zx90316/split-flap/mega2560/hall-diagnostics.md

# KY-003：確認輸出，再決定磁鐵方案

[分享對話](https://claude.ai/share/2f5c9351-a46a-44d2-a825-716c9a015ebe)回報：十片行為類似，元件標示`3144`／`306Y`；黑色磁鐵測試有時維持亮燈，正面觸發、反面解除；供電5V、S未接控制器、無磁場時量到 **3.39V**；2×1mm磁鐵當時未到貨。這是對話紀錄，尚無本repo實測波形或電路圖。

## 3.39V 不足以判定電路或鎖存

不能只憑這個數字斷定供電接錯、沒有上拉、一定透過LED上拉、是假3144或一定鎖存。S是訊號輸出，不必然等於供電；模組LED／電阻電路可能不同，電表讀值受上拉、漏電與負載影響。不能以「5V−LED 1.6V」直接認定內部電路。

[Allegro A3144原廠資料表](https://www.allegromicro.com/~/media/Files/Datasheets/A3141-2-3-4-Datasheet.ashx?la=en)描述單極開集極開關：磁場超動作門檻拉低，低於釋放門檻後釋放，需適當上拉。它不能證明相容品型號或模組走線，`306Y`也不足以辨識功能。

程式使用 **INPUT_PULLUP**，列出raw及觸發狀態，不對電壓作軟體認證。接上後須重新量S高低電位，並確認馬達開關時穩定。輸入門檻與供電有關，不能只因3.39V讀得到就忽略雜訊餘量；參考 [ATmega2560原廠資料](https://www.microchip.com/en-us/product/ATmega2560)與實板供電。

## 不轉馬達的確認流程

1. **關閉12V馬達分支**。查實板S／正電源／地，不能假設所有模組中間腳是+；裸IC腳序也不等於模組排針。
2. 先量+對−約5V，再記錄S對−在未觸發、靠近、直線移遠、換極時的電位與LED。沒有模組電路證據，LED只作輔助。
3. 接S→A0、+→Mega 5V、−→GND，`WATCH`：預設raw=LOW U0=1是觸發，raw=HIGH U0=0是釋放。`x`加換行退出。
4. 用磁極較明確的硬磁鐵，同一面靠近，再**不翻面、沿直線移離到充分遠**；約30cm可作桌面排查起點，同時移開磁化鐵件。不要以多極冰箱軟磁片作定論。
5. 若會回HIGH，再用實際2×1mm磁鐵、安裝距離驗證每圈單一磁區。若供電針序正常、移遠仍LOW、另一極可重複解除，先記為**疑似鎖存行為**，進一步對照料號資料／量測，不憑印字判真偽。
6. S接上INPUT_PULLUP後負載會改變，必須重測。持續LOW還需排除短路、錯腳、供電不穩、元件故障，不能宣稱只有鎖存一種原因。

| 模組 | +/−電壓 | S未接控制器 | S接INPUT_PULLUP | 靠近LOW | 移遠回HIGH | 翻極反應 | 備註 |
| --- | --- | --- | --- | --- | --- | --- | --- |
| U0 |  | 對話回報3.39V；待重測 |  |  |  |  |  |
| U1–U9 | 各片記錄 |  |  |  |  |  |  |

## 確認鎖存後的選項

基準機構每顆一磁鐵，離開後感測器應釋放。鎖存若只遇觸發極，不會自行回復，HOME會在離開磁區報`hall_did_not_release`，MEASURE也無法取得每圈新邊緣。改POLARITY或加長逾時無法修正。

可換已驗證非鎖存感測器；或**確認鎖存後**評估每顆兩個相反有效磁極，每圈在固定位置解除、觸發。十顆增為二十顆是這個選項的用量，不是本次已確定購買需求。

雙磁鐵須在實際滾筒驗證：同感測軌跡、磁場不互擾、每圈只有一個可重複的未觸發→觸發邊緣；兩段電位都足以穩定5ms，任意停點都能在步數／時間限制內先解除再觸發。**沒有「相隔90°一定成功」的通用保證**，本repo未新增孔位，也未做雙磁鐵實機驗證。

HOME／MEASURE使用相同邊緣流程，可測這種行為，但不代表機構已相容。方案變更後重測OFFSET與圈步數，不直接沿用單磁鐵校準。
