zx90316/split-flap/esp32cam/ui-preview.jpg

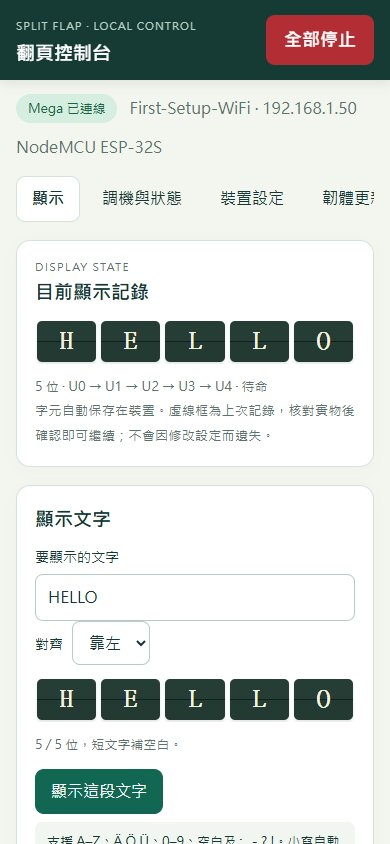
esp32cam/ui-preview.jpg
