zx90316/split-flap/hardware/project-bom.csv

item_id | item_name | specification | required_quantity | unit | quantity_basis | design_role | verification_needed | bench_quantity | recommended_purchase_quantity | availability
P001 | ULN2003 驅動板 | ULN2003；四相五線；輸入與插座映射須確認 | 10 | 片 | 十字元電氣設計 | 每字元一片低側驅動；COM 接 12V_MOTOR | 實際 IC、IN1–IN7 與馬達插座映射、輸入負載、reset 時關閉狀態、COM、額定值 | 1 |  | 依對話已有；未盤點
P002 | 28BYJ-48 步進馬達 | 28BYJ-48-12VDC；12V；四相五線 | 10 | 顆 | 十字元電氣設計 | U0–U9 各一顆 | 電壓標示、共同端、線圈電阻、相序、齒比、每圈步數、歸零偏移 | 1 |  | 依對話已有；未盤點
P004 | 雙面洞洞板 | 5×7 cm | 2 | 片 | 初始載板佈局；須試排 | Hall 3P 分線板與接線固定；孔位配置見 mega2560/README.md | 孔距、焊盤連通、實際佈局、絕緣與固定 | 1 |  | 依對話已有；未盤點
P005 | KY-003 霍爾感測板 | KY-003；數位磁感測 | 10 | 片 | 十字元電氣設計 | Mega A0–A9；5V供電；INPUT_PULLUP | 回報標示3144/306Y；針序、磁極、釋放行為及上拉待驗；3.39V不足以判定鎖存或內部電路 | 1 |  | 依對話已有；未盤點
P006 | 免焊 DC 母接頭 | 母頭 5.5×2.1 mm | 1 | 個 | 十字元電氣設計 | 標準 12V 輸入接頭；與電源插頭規格配對 | 極性、接點電流額定值、與供電插頭適配及固定 | 1 |  | 待確認
P011 | 8 路雙向電平轉換板 | 現有8路；3.3V／5V；分立MOS布局 | 1 | 片 | NodeMCU ESP-32S與Mega Pro UART | GPIO13→A0／B0→D19；D18→B1／A1→GPIO14；VCCA=3V3；VCCB=Mega5V | 各側電壓與共地；115200短線實測；不假設單側斷電隔離；切換供電前拔四條訊號線 | 1 | 0 | 依使用者已有；照片8路板；由選配移入
P012 | M3 熱熔螺母 | M3×0.5；Ø4.6×L5.8 mm | 14 | 顆 | 上游機構參考；須試裝確認 | 原中框與前蓋參考需求 14 顆 | 孔徑、埋入長度、壁厚與材料適配 |  |  | 待確認
P013 | M2×4 十字盤頭螺絲 | M2×0.4；長 4 mm | 20 | 支 | 上游機構參考；須試裝確認 | 原 Hall 固定參考需求 20 支；新 Hall 孔位待驗 | 頭型、長度、Hall 孔位與螺紋 |  |  | 待確認
P014 | M2×8 十字盤頭螺絲 | M2×0.4；長 8 mm | 20 | 支 | 上游機構參考；須試裝確認 | 原滾筒參考需求 20 支 | 頭型、長度、插入深度與滾筒干涉 |  |  | 待確認
P015 | M3×8 十字盤頭螺絲 | M3×0.5；長 8 mm | 12 | 支 | 上游機構參考；須試裝確認 | 原前蓋與後蓋參考需求 12 支 | 頭型、長度與固定配合 |  |  | 待確認
P016 | M4×8 十字盤頭螺絲 | M4×0.7；長 8 mm | 20 | 支 | 上游機構參考；須試裝確認 | 原馬達固定參考需求 20 支 | 頭型、長度與馬達耳孔 |  |  | 待確認
P017 | M4×20 十字盤頭螺絲 | M4×0.7；長 20 mm | 4 | 支 | 上游機構參考；須試裝確認 | 原中框參考需求 4 支 | 頭型、長度與固定配合 |  |  | 待確認
P018 | M3 六角螺帽 | M3×0.5；DIN934 | 32 | 顆 | 上游機構參考；須試裝確認 | 原 UnitFrame／前後蓋參考需求 32 顆 | 尺寸與螺帽嵌入孔 |  |  | 待確認
P019 | M4 六角螺帽 | M4×0.7；DIN934 | 4 | 顆 | 上游機構參考；須試裝確認 | 原中框參考需求 4 顆 | 尺寸與螺帽嵌入孔 |  |  | 待確認
P020 | M2 熱熔螺母 | M2×0.4；Ø3.59×L3.94 mm | 20 | 顆 | 上游機構參考；須試裝確認 | 原滾筒參考需求 20 顆 | 孔徑、埋入長度、壁厚與材料適配 |  |  | 待確認
P021 | M3×16 內六角杯頭螺絲 | M3×0.5；長 16 mm；DIN912 | 34 | 支 | 上游機構參考；須試裝確認 | 原 UnitFrame／前後蓋參考需求 34 支 | 頭型、長度與固定配合 |  |  | 待確認
P022 | 圓片釹磁鐵 | 2×1 mm | 10 | 顆 | 上游機構參考；須試裝確認 | 每字元歸零磁鐵 | 非鎖存單磁鐵基準10顆；確認鎖存並驗證雙磁鐵後才改為20顆 | 1 |  | 待確認
P023 | 穩壓直流電源 | 隔離式 12V DC | 1 | 組 | 十字元電氣設計 | 供馬達及LM2596控制支路；馬達分支可獨立切斷 | 依最大負載選連續/峰值額定電流；極性與接頭 | 1 |  | 待確認
P024 | 插片式保險絲座與配套保險絲 | 已購中號18AWG選項標5A×2；實際保險絲額定另核定 | 2 | 組 | 12V主輸入F1及5V控制支路F2 | F1靠近12V輸入口；F2在LM2596的5V輸出後 | 是否附保險絲；DC額定、最弱線材／接點、並行總電流、線長與熔斷曲線；不預設兩路5A | 2 | 0 | 2026-10-26使用者購買清單；已下單待出貨；未實機驗收
P025 | 直流電源開關 | 符合實測直流負載 | 2 | 個 | 十字元電氣設計 | 主電源開關及獨立馬達分支切斷 | 感性負載切斷能力、突波與可及性 | 2 |  | 待確認
P026 | 電源線、端子與分配件 | 主幹18–20AWG為起點；短單馬達分支可評估24AWG；依長度和額定值驗證 |  | 組 | 依佈線決定 | 12V/5V/地線分配 | 不可用未知線規杜邦線承擔馬達主幹 |  |  | 待確認
P027 | 訊號配線與接頭 | 短線 I²C、Hall 與相位接線 |  | 組 | 依佈線決定 | 其餘短線和標籤；多P線分列C001–C005；Pro公針用母頭、標準Mega母排用公頭 | 導通、標籤、拉力與雜訊 |  |  | 待確認
P028 | 固定柱、絕緣與應力消除件 | 依板孔及外殼選型 |  | 組 | 依實際固定方式決定 | 安全固定模組與配線 | 爬電間距、無裸線短路、機構干涉 |  |  | 待確認
P029 | 上拉、下拉與去耦元件 | 依模組內建電路和量測選型 |  | 組 | 依實測電路決定 | ULN相位下拉（10kΩ起點）及Hall上拉、去耦依實測配置 | 0–40相下拉；驗證reset與USB拔除狀態；無MCP RESET線 |  |  | 待確認
P031 | 翻頁片 | 與上游 45 字元順序一致 | 450 | 片 | 上游機構參考；須試裝確認 | 每字元 45 片 | 字元版本、厚度、翻落與排列 |  |  | 待確認
P032 | 滾筒與單元框架 | FlapDrumInner / Outer / FrameUnit | 10 | 組 | 上游機構參考；須試裝確認 | 十個字元單元 | 尺寸、摩擦、模組安裝孔 | 1 |  | 待確認
P033 | 中框、前蓋與後蓋 | 每類各左中右三件 | 1 | 套 | 上游機構參考；須試裝確認 | 整機外殼 | 插座與載板固定、絕緣及散熱 |  |  | 待確認
P034 | Arduino Mega 2560 | ATmega2560；5V；16MHz | 0 | 片 | Mega十字元規劃；現階段單顆測試 | 歷史硬體；非本次新主控 | 板型、母排、USB、reset時輸出關閉 | 0 | 0 | 原標準Mega仍保留；現行改用P040；舊板可備份校準
P035 | Mega USB 資料線 | Mega Pro板上USB接頭到貨核對；必須支援資料 | 1 | 條 | Mega燒錄與單板USB調機 | USB供電與115200串列 | USB與外部5V互斥；先拔板間四條UART訊號線；新COM不可沿用舊板號 | 1 | 1 | 待確認
C001 | 4P 馬達相位線 | Pro公針與ULN公針用母母；依各邏輯腳拆分束線 | 10 | 條 | Mega十字元規劃；現階段單顆測試 | 每字元一條；U9 D8–D11 | Pro排位不同；D22/24/26/28等不保證連續四針；不能按標準板外觀搬接 | 1 | 12 | 待確認
C002 | 3P Hall 線 | 2.54mm母對母；兩端元件為公針時 | 10 | 條 | Mega十字元規劃；現階段單顆測試 | 每字元一條；S/+/-由分線板分配 | 腳序依實物；不可把圖上順序當通用針序 | 1 | 12 | 待確認
C003 | 8P Hall 訊號線 | Hall分線板公針端母／Mega Pro公針端母；依印字接線 | 1 | 條 | Mega十字元規劃；現階段單顆測試 | S0–S7到A0–A7 | 分線板自訂連續8針；Pro端依邏輯腳拆分對接，不假設排位連續 | 0 | 1 | 待確認
C004 | 2P Hall 訊號線 | Hall分線板公針端母／Mega Pro公針端母；依印字接線 | 1 | 條 | Mega十字元規劃；現階段單顆測試 | S8–S9到A8–A9 | 與2P電源線分開標籤 | 0 | 1 | 待確認
C005 | 短1P跳線 | 依端點選公對母或公對公 |  | 條 | Mega十字元規劃；現階段單顆測試 | 單顆S/+/-及共地；其餘內接線 | 共地線另備；不得取代馬達主幹 | 3 |  | 待確認
C006 | 公排針 | 2.54mm 40P 可裁 | 2 | 排 | Mega十字元規劃；現階段單顆測試 | Hall分線板30+8+2+電源2針 | 依外殼選直針或彎針 | 1 | 3 | 待確認
C007 | 2P 馬達電源分支 | 明確線規的正負線及額定端子 | 10 | 組 | Mega十字元規劃；現階段單顆測試 | 端子台星狀分配到各ULN +/− | 短24AWG分支需驗證接點和壓降；禁止當主幹 | 1 | 10 | 待確認
C008 | 電源端子台 | 主分配及至少10路馬達分配 | 2 | 個 | Mega十字元規劃；現階段單顆測試 | 可獨立切斷12V分支；回流回分配點 | 直流額定及端子共通情況須確認 | 1 | 2 | 待確認
P036 | ESP32-CAM | AI-Thinker ESP32-S；4MB Flash；相機與SD停用 | 0 | 片 | 手機網頁控制台 | 歷史ESP32-CAM；不接入現行配線 | 實板腳位與5V／3V3；軟體需兩板一併更新 | 0 | 0 | 使用者回報短路損壞；隔離停用；改用P039
P037 | CP2102 USB-UART | 3.3V UART邏輯；USB資料傳輸 | 0 | 片 | ESP32-CAM燒錄與監看 | 新板內建USB-UART；不需要外接CP2102 | 量TXD邏輯與排針標示；不是5V邏輯轉接器 | 0 | 0 | 舊外接USB轉接器不再接入；曾回報USB部分短路，CP2102是否受損待確認
P038 | LM2596控制電源 | 現有可調板；12V→5.0V | 1 | 片 | 兩板獨立運作；沿用原O004 | 控制支路在馬達分支開關之前；5V分供ESP32的5V及Mega的5V腳 | 空載調5.0V；負載壓降／電流／溫升；任一板接PC USB前先拔該板外部5V與板間UART訊號 | 1 | 0 | 依使用者已有；由O004移入使用
C009 | 控制電源與UART內接線 | 沿用現有跳線；短線；固定與絕緣 |  | 組 | NodeMCU ESP-32S與Mega Pro內接 | 5V分支／3.3V轉換供電／共地／TXRX | 兩板各自外部5V與四條UART線須可拔；不接外部CP2102；核對新板5V電源腳 | 1 |  | 待確認
P039 | NodeMCU ESP-32S | classic ESP32／ESP-WROOM-32；預期4MB；板上USB；無PSRAM | 1 | 片 | 新購雙主控方案 | 手機網頁／Wi-Fi／時鐘／UART／ESP32 OTA | 到貨核對Flash、5V輸入／VIN電源路徑、USB-UART晶片與排針；GPIO13TX／GPIO14RX；不適用C3或S3 | 1 | 0 | 2026-10-26使用者購買清單；已下單待出貨；未實機驗收
P040 | Mega2560 Pro CH340G | ATmega2560／5V／16MHz；焊好排針 | 1 | 片 | 新購雙主控方案 | 1～10位ULN2003與Hall；Serial1收ESP32命令 | 相容bootloader；公母頭、邏輯腳印字與5V／GND；新EEPROM需匯入原校準 | 1 | 0 | 2026-10-26使用者購買清單；已下單待出貨；未實機驗收
P041 | 高溫金手指膠帶 | 10mm×33m | 1 | 卷 | 新購配線耗材 | 輔助絕緣與標記 | 不作唯一機械支撐或外殼絕緣；保留固定柱及應力消除 | 1 | 0 | 2026-10-26使用者購買清單；已下單待出貨；未實機驗收
P042 | 黑色單芯鍍錫銅線 | 銅芯直徑0.5mm；約0.196mm²／24AWG；500cm | 5 | m | 購買清單5m；非額定線長設計 | 短訊號線與洞洞板跨接；不作馬達總線 | 不是0.5mm²；支路需核對電流與壓降；避免反覆彎折；電壓與用途加標籤 |  | 0 | 2026-10-26使用者購買清單；已下單待出貨；未實機驗收
P043 | 4位DIP指撥開關 | 4位×4個；邏輯用途 | 0 | 個 | 已購4個備用；現版不接線 | 位數仍由網頁DIGITS／UNITS設定 | 腳對導通與接點額定；不切換馬達電源；沒有新增韌體讀取或啟動優先權 |  | 0 | 2026-10-26使用者購買清單；已下單待出貨；未實機驗收；已購數量4個
P044 | KF301 PCB螺絲端子 | 2P／約5mm間距×4 | 4 | 個 | 新購電源入口／出口端子 | 12V／受控馬達／5V入口與控制出口；需另焊分配導線 | 裸PCB焊接零件不是現成配電板；四個僅八夾線點；板銅／跨線／端子承受所經總電流 | 4 | 0 | 2026-10-26使用者購買清單；已下單待出貨；未實機驗收
C010 | NodeMCU板上USB資料線 | 接頭依到貨實板核對；必須支援資料 | 1 | 條 | 新ESP32板上USB燒錄與監看；與Mega可分別操作 | 取代外接CP2102資料連接 | 實際插頭、USB-UART驅動與COM；接USB前拔外部5V及UART | 1 |  | 既有線材是否適用待確認；不在本次購買截圖內
