zx90316/split-flap/hardware/esp32-project-bom.csv

item_id | item_name | specification | required_quantity | unit | quantity_basis | design_role | verification_needed
P001 | ULN2003 驅動板 | ULN2003；四相五線；輸入與插座映射須確認 | 10 | 片 | 十字元電氣設計 | 每字元一片低側驅動；COM 接 12V_MOTOR | 實際 IC、IN1–IN7 與馬達插座映射、輸入負載、reset 時關閉狀態、COM、額定值
P002 | 28BYJ-48 步進馬達 | 28BYJ-48-12VDC；12V；四相五線 | 10 | 顆 | 十字元電氣設計 | U0–U9 各一顆 | 電壓標示、共同端、線圈電阻、相序、齒比、每圈步數、歸零偏移
P004 | 雙面洞洞板 | 5×7 cm | 2 | 片 | 初始載板佈局；須試排 | 控制模組載板；2 片為初始佈局基準，實際面積須試排 | 孔距、焊盤連通、實際佈局、絕緣與固定
P005 | KY-003 霍爾感測板 | KY-003；數位磁感測 | 10 | 片 | 十字元電氣設計 | 十路歸零；5V 側接 MCP 0x23 | 感測 IC、針序、有效電位、非鎖存行為、磁極、上拉與原 3D 安裝孔
P006 | 免焊 DC 母接頭 | 母頭 5.5×2.1 mm | 1 | 個 | 十字元電氣設計 | 標準 12V 輸入接頭；與電源插頭規格配對 | 極性、接點電流額定值、與供電插頭適配及固定
P007 | 5V 降壓電源板 | MP2482／SY8205；7–24V→5V；連續額定電流須實測 | 1 | 片 | 十字元電氣設計 | 一片供 5V 控制電源；禁止並聯輸出 | 實際 IC、輸出電壓、連續電流、散熱、紋波、浪湧與用途
P008 | ESP32 開發板 | ESP-WROOM-32；30pin；Type-C／CH340 | 1 | 片 | 十字元電氣設計 | 唯一成品主控；GPIO21 SDA、22 SCL、23 open-drain RESET | 模組版本、排針焊接、Flash、腳位、5V 輸入與 USB 隔離；禁止直接 12V
P009 | MCP23017 擴充板 | MCP23017；I²C 16 位元；GPA7／GPB7 僅輸出 | 4 | 片 | 十字元電氣設計 | 0x20–0x22 馬達；0x23 Hall；全部 5V | 晶片標示、地址、上拉、排針、RESET 是否引出及可共同重設
P011 | 8 路雙向電平轉換板 | 8 路；3.3V／5V；分立 MOS 布局 | 1 | 片 | 十字元電氣設計 | 一片使用 SDA、SCL、RESET 三路 | MOS 型號、各側電源、上拉、通道對應、焊接與斷電回灌
P012 | M3 熱熔螺母 | M3×0.5；Ø4.6×L5.8 mm | 14 | 顆 | 上游機構參考；須試裝確認 | 原中框與前蓋參考需求 14 顆 | 孔徑、埋入長度、壁厚與材料適配
P013 | M2×4 十字盤頭螺絲 | M2×0.4；長 4 mm | 20 | 支 | 上游機構參考；須試裝確認 | 原 Hall 固定參考需求 20 支；新 Hall 孔位待驗 | 頭型、長度、Hall 孔位與螺紋
P014 | M2×8 十字盤頭螺絲 | M2×0.4；長 8 mm | 20 | 支 | 上游機構參考；須試裝確認 | 原滾筒參考需求 20 支 | 頭型、長度、插入深度與滾筒干涉
P015 | M3×8 十字盤頭螺絲 | M3×0.5；長 8 mm | 12 | 支 | 上游機構參考；須試裝確認 | 原前蓋與後蓋參考需求 12 支 | 頭型、長度與固定配合
P016 | M4×8 十字盤頭螺絲 | M4×0.7；長 8 mm | 20 | 支 | 上游機構參考；須試裝確認 | 原馬達固定參考需求 20 支 | 頭型、長度與馬達耳孔
P017 | M4×20 十字盤頭螺絲 | M4×0.7；長 20 mm | 4 | 支 | 上游機構參考；須試裝確認 | 原中框參考需求 4 支 | 頭型、長度與固定配合
P018 | M3 六角螺帽 | M3×0.5；DIN934 | 32 | 顆 | 上游機構參考；須試裝確認 | 原 UnitFrame／前後蓋參考需求 32 顆 | 尺寸與螺帽嵌入孔
P019 | M4 六角螺帽 | M4×0.7；DIN934 | 4 | 顆 | 上游機構參考；須試裝確認 | 原中框參考需求 4 顆 | 尺寸與螺帽嵌入孔
P020 | M2 熱熔螺母 | M2×0.4；Ø3.59×L3.94 mm | 20 | 顆 | 上游機構參考；須試裝確認 | 原滾筒參考需求 20 顆 | 孔徑、埋入長度、壁厚與材料適配
P021 | M3×16 內六角杯頭螺絲 | M3×0.5；長 16 mm；DIN912 | 34 | 支 | 上游機構參考；須試裝確認 | 原 UnitFrame／前後蓋參考需求 34 支 | 頭型、長度與固定配合
P022 | 圓片釹磁鐵 | 2×1 mm | 10 | 顆 | 上游機構參考；須試裝確認 | 每字元歸零磁鐵 | 磁極、Hall 距離、固定方式
P023 | 穩壓直流電源 | 隔離式 12V DC | 1 | 組 | 十字元電氣設計 | 供馬達與 5V 降壓輸入 | 依最大負載選連續/峰值額定電流；極性與接頭
P024 | 輸入保險絲與座 | 額定值依最弱導線及負載選定 | 1 | 組 | 十字元電氣設計 | 靠近 12V 輸入保護 | 熔斷特性、浪湧、接點額定值
P025 | 直流電源開關 | 符合實測直流負載 | 2 | 個 | 十字元電氣設計 | 主電源開關及獨立馬達分支切斷 | 感性負載切斷能力、突波與可及性
P026 | 電源線、端子與分配件 | 依電流、線長與壓降選型 |  | 組 | 依佈線決定 | 12V/5V/地線分配 | 不可用未知線規杜邦線承擔馬達主幹
P027 | 訊號配線與接頭 | 短線 I²C、Hall 與相位接線 |  | 組 | 依佈線決定 | 連接模組 | 導通、標籤、拉力與雜訊
P028 | 固定柱、絕緣與應力消除件 | 依板孔及外殼選型 |  | 組 | 依實際固定方式決定 | 安全固定模組與配線 | 爬電間距、無裸線短路、機構干涉
P029 | 上拉、下拉與去耦元件 | 依模組內建電路和量測選型 |  | 組 | 依實測電路決定 | I²C/RESET 上拉、驅動預設關閉及供電去耦 | 已有電阻並聯等效值、上升時間與重設狀態
P030 | USB 資料線 | USB Type-C 資料傳輸 | 1 | 條 | 開發與校準需求 | 燒錄及串列操作 | 資料能力、USB/外部供電隔離
P031 | 翻頁片 | 與上游 45 字元順序一致 | 450 | 片 | 上游機構參考；須試裝確認 | 每字元 45 片 | 字元版本、厚度、翻落與排列
P032 | 滾筒與單元框架 | FlapDrumInner / Outer / FrameUnit | 10 | 組 | 上游機構參考；須試裝確認 | 十個字元單元 | 尺寸、摩擦、模組安裝孔
P033 | 中框、前蓋與後蓋 | 每類各左中右三件 | 1 | 套 | 上游機構參考；須試裝確認 | 整機外殼 | 插座與載板固定、絕緣及散熱
