zx90316/split-flap/docs/esp32/wiring.md

# 接線表與通電前檢查

> 此文件為保留的 ESP32 方案；目前進度是 [Mega 2560 單顆調機](../../mega2560/README.md)。請勿混用接線與命令。

版本：2026-10-20。所有表格均為規劃，尚未完成實物驗證。不要把模組照片、模組標籤或此表當作已確認的物理腳位圖。先斷電查導通，再依 [組裝測試程序](assembly.md) 通電。

## 1. 電源域與 ESP32

| 網路／ESP32 腳 | 連接位置 | 注意 |
| --- | --- | --- |
| 12V_MOTOR | 每顆馬達共同正端、各 ULN 的 COM | 從獨立可切斷的馬達電源分支供應 |
| 5V_LOGIC | MCP VDD、KY-003 的已確認正電源腳、P011 HV、P008 已確認的 5V 輸入 | 單片 P007 降壓；禁止接 ESP32 GPIO 或 3V3 腳 |
| ESP32 3V3 | P011 LV | 只作 3.3V 電源域；不承擔馬達或 5V 負載 |
| GND | ESP32、P007、P011、MCP VSS、Hall 地、ULN E／GND | 共地；馬達回流獨立走線至分配點 |
| GPIO21 | P011 LV1；對應 HV1 接四片 MCP SDA | 開汲極 I²C SDA；兩側分別上拉 |
| GPIO22 | P011 LV2；對應 HV2 接四片 MCP SCL | 開汲極 I²C SCL；兩側分別上拉 |
| GPIO23 | P011 LV3；對應 HV3 接四片 MCP /RESET | ESP32 使用 open-drain，LOW 重設，釋放為 HIGH |

GPIO 編號是晶片 GPIO，不是排針第幾腳。P008 是 30pin 第三方板；先對照絲印與實物確認位置。P011 的 LV1/HV1 等名稱表示同一路的兩側，實際板子標示若不同，以導通測試確認。其餘五路不接訊號。

MCP 的 /RESET 在 5V 側需有確定上拉，LV3 在 3.3V 側也需有確定上拉。不能直接由 3.3V push-pull GPIO 驅動 5V 的 /RESET。若轉換板內建電阻不足或不存在，補足並記錄，並將所需阻值與數量記入組裝紀錄。

## 2. MCP 位址與方向

四片都採 VDD=5V，位址是 7-bit I²C 位址。A2/A1/A0 是位址腳，與 GPA0/GPB0 不同。下表 HIGH 接 5V、LOW 接 GND；不要懸空，焊橋切換方式依 P009 實板。

| 標籤 | 位址 | A2 | A1 | A0 | 用途 | IODIRA | IODIRB |
| --- | --- | --- | --- | --- | --- | --- | --- |
| M0 | 0x20 | LOW | LOW | LOW | U0–U3 馬達 | 0x00 | 0x00 |
| M1 | 0x21 | LOW | LOW | HIGH | U4–U7 馬達 | 0x00 | 0x00 |
| M2 | 0x22 | LOW | HIGH | LOW | U8–U9 馬達 | 0x00 | 0x00 |
| H0 | 0x23 | LOW | HIGH | HIGH | 十個 Hall | 0x7F | 0x07 |

方向位元 1=輸入、0=輸出。H0 的 GPA7、GPB3–7 設為輸出低、不要接外部訊號；M2 的全部 GPB0–7 也輸出低。所有 MCP 的 INTA／INTB 在此輪詢基準中未使用，不接 ESP32。

GPA7／GPB7 避免作輸入，依據 [Microchip DS20001952D](https://ww1.microchip.com/downloads/aemDocuments/documents/APID/ProductDocuments/DataSheets/MCP23017-Data-Sheet-DS20001952.pdf)。不要用其他版本或網路教學的 16 路輸入範例覆蓋此限制。

## 3. 每個馬達的四相對應

面向顯示器正面，最左側為 U0，最右側為 U9。每列 PH1–PH4 對應該字元的邏輯 bit0–3。下表不是「將 PH1 盲接板上 IN1」的指示；先完成下一節的實物映射。

| 字元 | MCP | PH1／bit0 | PH2／bit1 | PH3／bit2 | PH4／bit3 |
| --- | --- | --- | --- | --- | --- |
| U0 | 0x20 | GPA0 | GPA1 | GPA2 | GPA3 |
| U1 | 0x20 | GPA4 | GPA5 | GPA6 | GPA7 |
| U2 | 0x20 | GPB0 | GPB1 | GPB2 | GPB3 |
| U3 | 0x20 | GPB4 | GPB5 | GPB6 | GPB7 |
| U4 | 0x21 | GPA0 | GPA1 | GPA2 | GPA3 |
| U5 | 0x21 | GPA4 | GPA5 | GPA6 | GPA7 |
| U6 | 0x21 | GPB0 | GPB1 | GPB2 | GPB3 |
| U7 | 0x21 | GPB4 | GPB5 | GPB6 | GPB7 |
| U8 | 0x22 | GPA0 | GPA1 | GPA2 | GPA3 |
| U9 | 0x22 | GPA4 | GPA5 | GPA6 | GPA7 |

各 MCP 輸出只提供 ULN 輸入電流，不能直接供應線圈。若 P001 還有指示燈或其他輸入電路，需確認加總輸入負載不超出 MCP 的工作規格；不可把絕對最大額定值當工作目標。

MCP 在上電／reset 期間的高阻態不能依賴軟體來拉低。必須證明 P001 的實際輸入電路在浮接、控制域斷電與重設時都會保持關閉；無法證明時，馬達端各使用中的輸入須補合適的下拉電阻並驗證。阻值需同時滿足關閉電位、漏電與 MCP 輸出負載，不盲套數字。下拉電阻需求依實際輸入電路確認並記錄。下拉不能壓過仍輸出 HIGH 的 MCP，也不能取代實體電源切斷。

### P001 IN1–IN7 與插座確認，未完成前禁止接馬達電源

1. 所有電源、USB、馬達拔除，拍攝板子正反面與 IC 字樣，標記實際插座方向。
2. 查明板上 GND 連到 ULN E、COM 連到哪一個供電端及插座腳。不能假設標示「VCC」就是邏輯 5V。
3. 對照 IC 的正確封裝腳位，逐一追蹤 IN1–IN7 到其輸出，以及各輸出到馬達插座。一般 ULN2003A 的七路輸入與七路輸出是一對一，但板子可使用其中任意四路；依實板決定。
4. 量馬達五條線的電阻網路找共同端：共同端到四相的電阻應接近；兩相端之間通常約為前者的和。不要只依紅線或插頭外觀推定。
5. 在限流、馬達單獨固定的條件下確認四相連續順序。若只抖動，先切斷電源，再查相序與接頭；不要硬提高電壓。
6. 將邏輯 PH1–PH4 對應的實體 IN 名稱與馬達接點填入紀錄；調整線材或韌體相位映射後重新驗證。其餘未使用 ULN 輸入保持低，不要接無關訊號。

| 實板標籤 | PH1 實體 IN／插座腳 | PH2 | PH3 | PH4 | 共同正端／COM | 驗證日期 |
| --- | --- | --- | --- | --- | --- | --- |
| P001 樣本 |  |  |  |  |  |  |

若十片板子並非同版，逐片重做。原廠資料表只證明 IC 功能，不證明 P001 的走線、LED 電阻或 12V 相容性。[TI 原廠資料表](https://www.ti.com/lit/ds/symlink/uln2003a.pdf)

## 4. Hall 接線

十片 KY-003 的已確認電源腳接 5V、地腳接 GND、訊號腳接以下 H0 輸入。此版本沒有 Hall 接 ESP32 的通道。

| Hall／對應字元 | 0x23 腳位 | 16-bit 讀值的 bit |
| --- | --- | ---: |
| H_U0 | GPA0 | 0 |
| H_U1 | GPA1 | 1 |
| H_U2 | GPA2 | 2 |
| H_U3 | GPA3 | 3 |
| H_U4 | GPA4 | 4 |
| H_U5 | GPA5 | 5 |
| H_U6 | GPA6 | 6 |
| H_U7 | GPB0 | 8 |
| H_U8 | GPB1 | 9 |
| H_U9 | GPB2 | 10 |

先確認感測器料號、針序、非鎖存／鎖存行為、板上上拉及磁極方向。KY-003 是模組名稱，不能保證所有模組版本的電路完全相同。基準可先以「有磁時 LOW」測試，但必須用電表／邏輯讀值驗證後才把有效電位寫入設定。離開磁鐵後必須恢復，否則不適合直接套用單磁鐵邊緣歸零。

開漏輸出必須有到 5V 的適當上拉。可在確認模組後使用 MCP 對應輸入的弱上拉（GPPUA=0x7F、GPPUB=0x07），但它不能取代長線上的訊號品質檢查，也不要與不明板上電路直接疊加。馬達電源與 Hall 訊號分開走，避免線圈開關造成假觸發。

## 5. I²C 與 /RESET 品質

初次採 100kHz；在確定電氣波形與排程餘裕後才考慮 400kHz。ESP32↔P011↔四片 MCP 盡量集中、短線，縮短分支。不要照上游每個 Nano 的長串接線束直接延伸這個新匯流排。

- 斷電確認每片 MCP 與 P011 已裝多少上拉。並聯總阻值由所有板子共同決定，不是只看單片電阻。
- LV 的 SDA/SCL 僅上拉到 3.3V，HV 僅上拉到 5V；任何跨錯側的上拉先修正再通電。
- 上拉過弱使上升太慢，過強則加重拉低電流。以實際等效阻值、線路電容、低電位及上升時間選擇，不預先指定所有板子都加同值電阻。
- 計算可用 `R_min=(Vpullup−VOL_max)/I_sink`、`R_max≈t_r/(0.8473×C_bus)` 作檢查，且須同時滿足兩側元件與轉換 MOS 的限制。[NXP UM10204 §7.1](https://www.nxp.com/docs/en/user-guide/UM10204.pdf)
- 邏輯分析儀能檢查 ACK／資料；要確認上升時間、低電位及過衝，需適當示波器。無波形證據時，不能只因掃描找到位址就宣稱完整十字元匯流排穩定。
- 分立 MOS 轉換板不是通用隔離器，也不保證斷電隔離。電源域未供電時，不要經其他仍通電的訊號腳回灌。
- 初始化、斷線測試與模組更動都先斷 12V_MOTOR。普通 I²C 線不作帶電插拔總線。

## 6. 初始化契約

馬達電源保持實體關閉。5V 與 3.3V 穩定後：

1. GPIO23 以 open-drain 拉低至少 10µs，再釋放 /RESET。確認高壓側回到 5V，高低電位／脈寬符合 MCP 規格。
2. 確認四個位址全有回應；缺任何一個不得進入馬達操作。
3. reset 已建立 BANK=0 的已知狀態。確認 IOCON=0，維持預期的連續暫存器操作；不要在未知 BANK 狀態下盲寫。
4. 所有 OLATA／OLATB 先清為 0，再設定各板 IODIR。對 Hall 配置輸入、所需上拉與不反轉的原始輸入讀值。
5. 讀回方向與輸出鎖存設定，確認馬達 40 路輸入低、所有未用輸出低。
6. 手動靠近／移開磁鐵，確認十路一對一對應。最後才容許接通馬達分支、選一顆試動與歸零。

批次輸出必須維護每片 MCP 的完整 16-bit shadow；更新一個 nibble 時保留同片其他馬達。讀 GPIO 不可拿來覆蓋其他馬達的輸出鎖存。不能把一次 I²C 寫入失敗當成馬達已停。

## 7. 最低通電檢查清單

- [ ] PD/QC 12V、極性、電流規格、斷電重啟行為與接頭適配已記錄
- [ ] 5V 輸出在接控制板前已空載／負載確認；3.3V 及 USB 隔離路徑已確認
- [ ] 保險絲、馬達實體切斷、主電源配線與接點額定值已確認
- [ ] MCP、P011、Hall、ULN 針序與供電域無交叉
- [ ] P001 的四相輸入與馬達共同端、COM 已逐項查明
- [ ] ULN 輸入在 reset／浮接／控制域斷電時確實關閉，必要的下拉已配置並測試
- [ ] 三條電平轉換線與雙側上拉、/RESET 共接已驗證
- [ ] 0x20–0x23 無地址衝突；所有馬達輸出初始化為低
- [ ] 馬達與翻頁無機械卡滯；導線不碰旋轉部件

空白核取方塊表示未完成，不是待補登的通過紀錄。
