zx90316/split-flap/esp32cam/validation.md

# NodeMCU ESP-32S＋Mega2560 Pro 驗證與實機驗收

## 2026-11-01：舊版 OTA 中止與 1.3.1 修正

使用者回報 1.2.0 在開始上傳約 1～3 秒後出現「更新期間 Mega 失聯或停止狀態已改變」。關閉其他控制頁後，以 mDNS 確認實板位址為 `192.168.68.62`（`splitflap.local`），先前 `.66` 已屬其他設備。使用目前管理密碼正常驗證，不記錄密碼或登入憑證。

- 更新前連續 20 次讀取：1.2.0、Mega 在線、最大快照年齡 445ms，停止／未 ARM、無忙碌、儲存、監看、不確定或 USB 接管。現場為 **10 位 U0～U9**，保留使用者設定。
- 封裝／SHA-256 校驗及正常 STOP 確認後，以 2048 bytes／60ms 單次慢速上傳 1.3.0。傳輸約 32 秒到 100%，最終 HTTP 400 回覆同一錯誤；**不代表刷入成功，沒有自動重試**。
- 更新後仍是 1.2.0、boot 不變，Mega 在線、停止、未 ARM、無不確定狀態。十組配置與備份一致，已保存最後顯示歷史；未發送 ARM／HOME／顯示／校準命令。
- 舊版將完整快照年齡 >1500ms 與真正失聯合併成同一錯誤。Flash 擦寫會影響任務／UART 接收，為本次軟體調查方向；沒有失敗瞬間快照，不能宣稱已證實唯一原因。參考 [Espressif SPI Flash concurrency](https://docs.espressif.com/projects/esp-idf/en/stable/esp32/api-reference/peripherals/spi_flash/spi_flash_concurrency.html)。
- 1.3.1 在每次實際 Flash 寫入後等待新的完整狀態，最多 2500ms；未收到時不繼續寫入。真斷線／換 session／停止狀態改變／USB 或配置改變仍立即中止，並提供不同錯誤訊息。沒有放寬 1500ms 的可寫入狀態新鮮度。

| 驗證 | 結果與範圍 |
| --- | --- |
| OTA 正式 guard＋雙板 UART 模擬 | 通過；20 次寫入後新完整快照、短暫過期恢復、2500ms 逾時、12 種中止狀態及 millis 溢位 |
| 動作／通訊／儲存回歸 | 全部通過，包含前節 1.3.0 功能 |
| Python 工具／HTTP fixture | 15 項通過；加入慢速工具登入、STOP ticket、有效／錯誤封裝與模擬上傳 |
| 正式建置 | Flash 1,084,425／1,966,080 bytes；全域 RAM 56,824／327,680 bytes |
| 1.3.1 最終產物 | app 1,084,576 bytes；封裝 1,084,640 bytes；SHA-256 `b3439e8f9f3b332a9b05cd81276b72c24d08e4bdedc23a7e2c4965e388bc6f98`；`.bin`、封裝與 metadata 一致 |
| 現場狀態 | **尚未安裝 1.3.1**；等待 ESP32 外部電源／UART 分離後單獨接 USB。新版實際 OTA、頁面登入及馬達功能仍待實板驗收 |

本機證據（忽略版本控制）：`.tools/ota-recovery-2026-11-01/` 保存前後配置／狀態與字元歷史；`.tools/ota-20261101T141320Z/` 保存本次單次上傳結果。工具不保存密碼、CSRF 或 ticket。USB 更新不需清除 NVS；完成後須比對十位配置與歷史，再由使用者恢復正常外部接線。

## 2026-11-01：1.3.0 網頁、校準與復電流程

本次完成程式與電腦驗證，**尚未刷入實板、未下發實體馬達動作**。原 1.2.1 的 Digest 修補由頁面登入完整取代；下方 1.2.1 紀錄為先前版本歷史，不是目前待部署產物。

- 位數固定 U0～U(N−1)，移除網頁 ARM／自訂排列；顯示與測試自動準備。
- 歸零、偏移數字預覽、前進 1／10／100、確認保存、取消復原均由 ESP32 流程執行；只在確認後永久保存。全部停止／失聯／霍爾失敗不接續後續動作。
- 首次完成全部校準後開啟復電恢復；正常上電等待 Mega、歸零，再依當下時間／最後畫面恢復。OTA／異常重啟不自動轉動。校準與測試不覆蓋正常顯示歷史。
- 時鐘含 12／24 小時、秒數、日期、英文星期；最多 8 項時間／文字輪播、停留秒數、跨午夜顯示時段。忙碌時跳過過期時間；動態畫面最多每分鐘保存一次。
- 頁面登入使用獨立持久 Cookie；無 Digest challenge。401 停止輪詢，保留草稿，不重送動作。
- 保留舊版網路與管理密碼，遷移 v2 設定；匯出 schema 2，支援連續清單的 schema 1，非連續清單拒絕。

| 驗證 | 結果與範圍 |
| --- | --- |
| 正式動作核心＋雙板 UART 模擬 | 通過；自動 ARM、四位依序取得 Hall 後恢復文字、後續時間目標延後計算、STOP 取消剩餘動作、缺失 Hall、失聯、重複請求、外部結果不被 20 次內部命令擠掉 |
| 既有通訊／運動回歸 | 通過；45 字元、1～10 位、並行、丟 ACK／DONE／命令、斷線／重連、USB／OTA 鎖、十位慢速並行 |
| 新顯示／儲存／登入核心 | 通過；午夜／中午／閏日、格式寬度、跨午夜時段、v1→v2 密碼保留、CRC／失敗寫入、校準簽章、輪播 JSON、持久登入與單獨登出 |
| Python 工具／HTTP fixture | 14 項通過；封裝、內嵌頁面、驗證／CSRF、連續配置、OTA 錯檔／ticket |
| 手機／桌面網頁 | 9 組流程通過，390×844／1100×900 無溢出、無 JS 例外；含多瀏覽器登入、失效暫停、草稿保留、完整偏移流程、1／5／10 位、輪播、備份、模擬復電／OTA |
| 正式 ESP32 建置 | Flash 1,083,901／1,966,080 bytes；全域 RAM 56,792／327,680 bytes；Arduino-ESP32 3.3.12 |
| 最終更新產物 | app 1,084,048 bytes；封裝 1,084,112 bytes；SHA-256 `d96fc43b9f660d39ac5b1fe109dc4ffc65638d720faff2abcbede40414be5718` |
| 最終產物核對 | `.sffw` 長度／協定／SHA、`.bin`、metadata 及內嵌網頁源碼一致 |
| 實板驗收 | 待更新；不能將模擬器成功當成實際供電、馬達、霍爾或 Flash 驗收 |

建置與測試命令：`python esp32cam/tools/dev.py build`、`python esp32cam/test/run.py`、`python -m unittest discover -s esp32cam/test -p test_*.py`、`python esp32cam/tools/dev.py test-web`。測試過程曾修正一筆低於支援年份下限的測試資料，最終回歸全部通過。

截圖與瀏覽器結果在 `test/.build/v130-mobile-settings.png`、`v130-desktop-clock.png`、`browser-results.json`，使用本機模擬資料。沒有新建串列監看、裝置背景輪詢或實板更新。

現場驗收順序：用既有停止／準備更新流程刷入 1.3.0 → 重新開頁並登入 → 確認位數 → U0 歸零／偏移／保存 → 文字與停止 → 正常斷電復電恢復 → 多位及時鐘輪播。第一次更新後不自動運動；首次全部校準確認後才開啟復電功能。

## 2026-10-31：1.2.1 修正反覆登入

使用者回報登入後仍頻繁出現瀏覽器登入視窗。確認 Arduino-ESP32 3.3.12 的 WebServer 僅保存一組 nonce／opaque，而每次 `requestAuthentication` 都重生兩者。其他客戶端的未登入請求因而使既有登入失效；舊頁面每秒重試，會持續觸發登入視窗。本次背景唯讀觀察也觸發此問題，已停止；觀察只收到 36 次無通訊錯誤的進度回報，沒有完成十分鐘驗收。

- 正式 `DigestServer` 為本次開機保留同一組 challenge，仍由原 WebServer 檢查目前管理密碼；重開機產生新 token。
- 頁面在 HTTP 401 時先處理登入失效，再解析資料；停止背景輪詢與可見性重試、清除 OTA ticket，顯示「重新登入」。每次手動重試只發出一個查詢，成功後恢復操作；文字／JSON 兩類 401 都涵蓋。
- 固定核心及板型不變，版本升為 1.2.1；僅需更新 ESP32。

| 驗證 | 結果 |
| --- | --- |
| 正式核心／Digest 回歸 | 既有通訊／顯示核心通過；正式 challenge policy 連續 32 次拒絕請求仍保留其他客戶端 token，重開機則產生新 token |
| 工具／HTTP fixture | 14 項通過；含封裝、資源一致性、設定與 OTA 流程 |
| 網頁 | 八組手機／桌面流程全部通過，無 JS 例外；文字及 JSON 401 都停止自動查詢，手動重試失敗後仍保持暫停，成功後恢復 |
| 正式 ESP32 建置 | Flash 1,073,609／1,966,080 bytes，全域 RAM 53,944／327,680 bytes |
| 更新產物 | app 1,073,760 bytes；`.sffw` 1,073,824 bytes；SHA-256 `8356f9d6c12e872e51048371c8682c408104c1b3e2f15f4f4966485b3c28c679` |
| 實板更新 | 更新檔已準備，等待關閉控制頁後透過 Wi-Fi OTA 更新與雙客戶端實測 |

更新前讀到的現場狀態：ESP32 1.2.0、Mega 已連線，無錯誤／協定不符／不確定狀態；NVS 與字元保存狀態正常。只啟用 U0，未 ARM、未定位、自動顯示暫停；`REVSTEPS=4096 OFFSET=0 SPEED=800 ACCEL=800 DIR=1 ORDER=1234 POLARITY=LOW`。舊 U0 的 OFFSET=273 尚未搬移。使用者確認目前兩板外部供電各接 5V 腳，現場狀態正常，後續聚焦登入與功能驗收。

## 2026-10-31：P011 冒煙後的主控存活檢查

使用者回報 P011 的 VCCB 供電處短路冒煙，VCCB 接 LM2596 標稱 5V、VCCA 接 ESP32 3V3；事故當時 Mega 是以 5V 接 VIN。後續使用者確認 P011、ESP32、Mega、LM2596 OUT− 四者共地，並於輸出與主控／P011 分離後量得 LM2596 OUT+ 對 OUT− 為 5V。實際短路兩端、模組腳序、事故當下極性與瞬態尚未釐清，不將上述接法直接判定為事故原因。

檢查前，使用者已將外部電源、馬達 12V、P011 的全部電源／訊號線及其他外接線與兩塊主控分離。使用者回報兩板本體沒有焦味；斷電量測 Mega 5V–GND 初讀 169、複測無限大，ESP32 5V–GND／3V3–GND 均無限大。這些電阻讀值只作為上電前篩查，不能證明所有元件完好。

| 事故後檢查 | 結果 |
| --- | --- |
| Mega 單獨 USB／COM5 | 正式韌體開機選單正常；三次 `STATUS ALL` 均回覆 U0 `armed=0 homed=0 reference=NONE error=none`，仍為一位、OFFSET=0 的預設設定 |
| ESP32 單獨 USB／COM7 | 正常 `POWERON_RESET`／`SPI_FAST_FLASH_BOOT`，顯示 `NodeMCU ESP-32S 1.2.0`；三次 `STATUS` 正常，`running=0`，未見啟動故障 |
| ESP32 Wi-Fi／HTTP | 取得家用網路 IP `192.168.68.66`；電腦唯讀請求 `/` 回 HTTP 401 與 `SplitFlap` Digest 登入驗證，確認 Wi-Fi 與網頁服務仍運作。IP 為本次 DHCP 結果，不視為固定地址 |
| 共地／LM2596（使用者確認） | 四者共地；事故後獨立、空載輸出讀值為 5V。尚未量測主控負載下電壓、瞬態或各板 5V／3V3 電源軌 |

結論限定為：**兩顆主晶片在單獨 USB 供電下仍能執行正式韌體並回覆；ESP32 的 Wi-Fi／HTTP 也仍運作。** GPIO13／14、Mega D18／D19、其他 I/O、VIN 穩壓路徑、各板實際 5V／3V3 電壓及 LM2596 負載／瞬態輸出尚未驗證，不能據此排除局部損傷。沒有重新燒錄、匯入設定、寫入 EEPROM 或執行 ARM／運動命令。

當次存活檢查期間 P011 隔離停用；後續現場恢復狀態見本頁最上方紀錄。事故後日誌保存在忽略版本控制的 `.tools/incident-check-2026-10-31/`；下節的三分鐘雙板 USB 測試是事故前紀錄。

## 2026-10-31：新板 USB 燒錄與開機初驗

兩塊新主控已到貨，本節為實板測試。使用者確認兩板僅接電腦 USB，外部 5V／板間 UART 已拔除、馬達 12V 關閉；本次只燒錄及查詢，沒有執行 ARM、定位或運動命令。

| 項目 | 實測結果 |
| --- | --- |
| 本機連接埠 | Mega2560 Pro 為 `COM5`；NodeMCU ESP-32S 為 `COM7`。兩者均列為 CH340、VID `1A86`／PID `7523`，無 USB 序號；換插孔後須重新確認，不靠晶片廠牌或舊 COM 號推定板型 |
| Mega 晶片／bootloader | 唯讀簽章 `1E 98 01`，確認 ATmega2560；Wiring／STK500v2、115200 可正常通訊 |
| Mega 建置／燒錄 | AVR 1.8.8；Flash 32,110／253,952、全域 RAM 2,360／8,192 bytes；正式 `dev.py upload --port COM5` 重建、上傳並啟用驗證，成功結束 |
| Mega EEPROM | 燒錄前後各唯讀備份 4,096 bytes，逐份雜湊一致；兩份皆為 `0xFF`，沒有既有校準。沒有匯入舊板參數或寫入 EEPROM |
| ESP32 晶片／Flash | ESP32-D0WD-V3、revision v3.1、40MHz 晶振；Flash 廠商 `20`／裝置 `4016`，實測 4MB，符合 classic ESP32／4MB 建置設定 |
| ESP32 建置／燒錄 | Arduino-ESP32 3.3.12、韌體 1.2.0；Flash 1,073,649／1,966,080、全域 RAM 53,944／327,680 bytes。開機程式、分割表、boot_app0 與正式 app 全部寫入，各區段均回報 `Hash of data verified` |
| ESP32 正式映像 | app 1,073,792 bytes；SHA-256 `487660f1fddc7a5b28d6cf39226c2b58758ee9fddc40e249da3b043a6d4d01c1`，與 1.2.0 既有建置紀錄一致 |
| 開機與狀態 | Mega 正式選單及兩次 `STATUS ALL` 正常；ESP32 完整拔插 USB 後顯示 `NodeMCU ESP-32S 1.2.0`，三次 `STATUS` 正常。Mega `armed=0`、`error=none`；ESP32 `running=0` |
| 雙板 USB 穩定性 | 兩板同時接 USB，01:38:18–01:41:22（Asia/Taipei）；有效觀察 180.39 秒，每 5 秒查詢一次，各 36／36 次正常回覆，零失聯／故障，沒有非預期重啟。Mega 持續未 ARM、ESP32 持續 `running=0`；`usb-stability.json` 回報 `passed=true` |

ESP32 本次自動進入下載模式未成功，改用「按住 BOOT → 按一下 EN → 放開 BOOT」，以 `--before no-reset` 保留下載模式後完成燒錄。後續串列控制線重設／EN 測試一度沒有收到資料；完整拔除 USB 約 10 秒再接回後，取得正常的 `POWERON_RESET`／`SPI_FAST_FLASH_BOOT`、1.2.0 開機訊息及狀態回覆。自動重設的可靠性仍待確認，不將此項列為通過。

實測狀態摘要：

```text
COM7: Split-Flap NodeMCU ESP-32S 1.2.0. UART2 RX=14 TX=13; Mega Serial1 115200.
COM7: Mega=offline digits=1 AP=192.168.4.1 STA=0.0.0.0 running=0
COM5: DIGITS=1 UNITS=0 SELECTED=U0 UPDATE=PARALLEL
COM5: U0 armed=0 homed=0 reference=NONE value=UNKNOWN index=0 REVSTEPS=4096 OFFSET=0 SPEED=800 ACCEL=800 DIR=1 ORDER=1234 POLARITY=LOW error=none
```

`Mega=offline` 是板間 UART 尚未恢復時的預期狀態；兩個 USB 埠同時可用不代表板間通訊已通過。新 Mega 目前只啟用 U0、OFFSET=0；舊 U0 的 OFFSET=273 等校準尚未搬移。EEPROM 備份及隱去密碼的本機日誌保存在忽略版本控制的 `.tools/board-validation-2026-10-31/`。本次沒有驗證外部供電、UART、Hall、馬達負載、手機連線或 OTA。

## 2026-10-28：提交前 review

- 修正協定文件仍使用舊 CAM OTA magic／tag 的內容，改為與韌體及封裝工具一致的 `SFESP01\0`／`splitflap-32s-v1`。另明列 schema 1 設定備份沿用舊 device 識別以匯入既有校準。
- OTA 錯協定、錯 magic、錯專案與容量超限分別驗證；超限案例保留合法 ESP32 映像前綴、長度及 SHA-256，避免其他錯誤掩蓋容量檢查。正式 C++ header 解析另驗最小／最大長度邊界與舊 CAM 拒絕。
- 校正 BOM 中殘留的標準 Mega 母排描述、兩板 USB 供電切換，以及已購 DIP 數量的用詞；未新增 DIP／繼電器 GPIO 控制。
- 重新執行 Mega 9 項工作流程測試、bench 15 組、panel 7 組及 .ino／協定／EEPROM／遠端回歸，全部通過。
- ESP32 14 項工具／HTTP 測試、正式通訊／顯示核心、七組手機／桌面網頁流程全部通過。生成資源一致性、BOM 欄位／料號／數量、VS Code 任務引用與文件連結檢查通過。
- 兩板正式建置通過，容量及 ESP32 映像 SHA-256 與下方 1.2.0 紀錄一致。建置與測試沒有開啟 COM、燒錄或操作馬達；沒有新增新板到貨／實測結果。

## 2026-10-26：1.2.0 新購硬體版

依[購買清單](../hardware/purchased-2026-10-26.md)更新。**兩塊新板尚待出貨，以下通過項目均為電腦上的軟體建置／模擬，不是新板實測。** 本次沒有開啟 COM、燒錄、讀寫實板 EEPROM 或驅動馬達；既有 U0 OFFSET=273 現場校準紀錄完整保留於 [Mega 驗證](../mega2560/validation.md)。

| 項目 | 結果 |
| --- | --- |
| Mega Pro 正式建置 | Arduino AVR 1.8.8；`arduino:avr:mega:cpu=atmega2560`；Flash 32,110／253,952、全域 RAM 2,360／8,192 bytes |
| NodeMCU ESP-32S 正式建置 | Arduino-ESP32 3.3.12；classic ESP32／4MB／DIO／40MHz／PSRAM disabled／min_spiffs；Flash 1,073,649／1,966,080、全域 RAM 53,944／327,680 bytes |
| 最終 OTA 產物 | `esp32cam/dist/splitflap-esp32s.sffw`；app 映像 1,073,792 bytes，封裝 1,073,856 bytes；64-byte header |
| 映像 SHA-256 | `487660f1fddc7a5b28d6cf39226c2b58758ee9fddc40e249da3b043a6d4d01c1`；詳細板型與版本另存 `dist/firmware.json` |
| Mega 工作流程 | 9 項 Python 測試通過；建置不開 COM、失敗停止、上傳後才監看等 |
| Mega 核心回歸 | bench 15 組、panel 7 組；1～10 位並行／稀疏映射、STOP、故障、手動／Hall、加減速；實際 .ino stub、4,000 封包、EEPROM 每寫入點斷電、遠端 lease／USB 接管測試全部通過 |
| ESP32 工具與 HTTP fixture | 14 項 Python 測試全部通過，含新板封裝、舊 CAM 即使內含合法 ESP32 映像仍拒絕；最終資源重生後另重跑 5 項產物測試通過 |
| 正式 C++ 通訊／網頁核心 | 全 45 字元／時鐘／日期／JSON、1～10 位並行通訊、遺失 ACK／DONE、重連／失聯、USB／OTA 鎖、Wi-Fi 設定與字元記憶全部通過；正式 otaHeader 拒絕 CAM 識別 |
| 手機網頁 | 390×844／1100×900，七組瀏覽器流程全部通過、沒有 JS 例外或橫向溢出；加入 NodeMCU 硬體名稱與舊 CAM OTA 錯檔拒絕、失敗後可重新準備 |
| 接線 SVG | 五張 XML 皆有效；四張嵌入頁面可解碼；五張皆經無頭 Chrome 轉 PNG，文字無畫布溢出；已人工檢視電源／UART、USB、十位與 Hall 圖，最終 F2 在 5V 分支分流之前 |
| BOM／VS Code／文件 | CSV 欄位及 ID 唯一、七類購買數量、停用舊板、F1／F2 待定額定、DIP 備用；重生圖／gzip／VS Code 前後雜湊一致，無重複任務／輸入，preLaunchTask 與文件連結有效 |

正式建置與主機測試最初受到本機受限執行環境的 Windows DLL／127.0.0.1 存取限制，改在一般執行環境完成上述純建置／模擬。這不是實板硬體錯誤；沒有因而操作硬體或改系統驅動。

### 新硬體到貨後驗收

- [ ] 核對板型、Flash、USB 接頭／USB-UART 晶片與 NodeMCU 5V／VIN 電源路徑；Pro 公排針依邏輯腳逐線導通確認。
- [x] 分別只接板上 USB，確認新 COM 及燒錄／開機狀態；Mega `armed=0`、ESP32 `running=0`（2026-10-31）。
- [ ] 新 ESP32 以 ACCESS 取得新 Wi-Fi／登入資料，實際以手機連線。
- [ ] 無負載與 Wi-Fi／多位負載下量 LM2596 5.0V、3V3、總電流及接點壓降／溫升；確定線徑、F1／F2 熔斷值及直流開關額定。購買選項 5A 尚未核准為設計值。
- [ ] 外部 5V 與 USB 互斥；切換前實際拔除該板外部 5V／四條 UART 線。P011 不假設單側斷電隔離。
- [ ] 還原舊 Mega 校準／安裝設定；新 EEPROM 不含舊板資料。先只啟用 U0，核對 OFFSET=273 的實物空白頁及 HOME，重新定位／ARM 後試文字。
- [ ] 新板短線 115200 UART 至少十分鐘、運動中查狀態、兩秒失聯 STOP／失效／重新定位，並測手機離線後工作繼續。
- [ ] 逐顆增加其餘位置，再驗實際位數與非連續映射、同時翻轉、總線壓降／溫升及手動斷電。
- [ ] 實機 OTA：錯檔拒絕、有效 ESP32-S 更新、中斷後重試、更新保留設定但不 ARM；Mega 仍用 USB。

DIP 先備用，不承擔馬達電流、不接 GPIO；依使用者確認，繼電器維持選配，IN 未確認不接。現版 STOP 關閉相位，沒有自動切斷 12V 馬達支路。接線以[新逐線表](wiring.md)為準。

## 舊 ESP32-CAM＋標準 Mega 的 1.1.0 紀錄

以下保留舊硬體建置與現場排查歷史，數字／接線／COM 與其未勾選清單不套用到新板；原始穩定基準是 `e65f30e`。

建置／自動測試日期：2026-10-25，Asia/Taipei，韌體 1.1.0。實機紀錄保留各次測試範圍；2026-10-26 使用者已回報現版實際運行通過，詳見「已有實機紀錄」。並行負載、NVS 斷電保存等逐項驗收未另提供紀錄。

## 正式建置

| 項目 | 結果 |
| --- | --- |
| Arduino CLI | 1.5.1 |
| Mega | `arduino:avr@1.8.8`；`arduino:avr:mega:cpu=atmega2560`；建置成功 |
| Mega Flash／全域 RAM | 32,110／253,952 bytes；2,360／8,192 bytes |
| ESP32-CAM | 韌體 1.1.0；`esp32:esp32@3.3.12`；`esp32:esp32:esp32cam:PartitionScheme=min_spiffs`；建置成功 |
| ESP32 Flash／全域 RAM | 1,088,373／1,966,080 bytes；54,000／327,680 bytes |
| OTA 產物 | `esp32cam/dist/splitflap-esp32cam.sffw`；app 映像 1,088,528 bytes，封裝額外 64 bytes |
| 網頁 | 所有 HTML／CSS／JavaScript 與四張接線 SVG 隨韌體 gzip 提供，無外部 CDN |
| 診斷 | 本次建置無專案編譯警告；容量是編譯器統計，不含執行時的堆疊／動態記憶體峰值 |

`dist/firmware.json` 保存當次映像 SHA-256、板型、核心及協定版本。建置產物與下載的工具不提交 Git；重建可重新產生。

先前接線修訂：改用使用者現有 P011 8 路 MOS 轉換板的 A0／B0、A1／B1；移除額外電平模組、專用去耦電容與 USB 電源小板的採購需求。正常供電改為現有 LM2596 穩壓 5.0V 接兩板 5V 腳，Mega USB 與外部 5V 互斥。當時僅更新兩張 SVG、接線步驟及 BOM，未修改韌體、腳位或 115200 速率；此次 1.1.0 的功能更新則需重刷兩板。

先前接線修訂已通過三份 BOM 的 CSV 欄位與料號唯一性、現有轉換板採購量為零、兩張 SVG 的 XML／腳位標示及重生一致性檢查，並轉圖檢視 UART 方向、5V 電源切換與文字排版。1.1.0 沿用相同硬體；下列韌體建置與功能測試已重新執行，沒有重新燒錄或操作實板。

## 自動測試結果

| 範圍 | 通過內容 |
| --- | --- |
| Mega 工作流程 | 9 項 Python 測試：先建置、失敗停止、驗證上傳後才監看、埠號驗證、建置不開埠、工作目錄與子程序管理 |
| Mega 運動／多位核心 | 15 組 bench、7 組 panel；所有 DIGITS 1～10 同時起步、總時間不疊加、非連續順序、批次預檢、相同字元不動、任一故障停止全部；速度／加速度與無變更設定保留定位／ARM，幾何校準僅使受影響位置失效，映射變更保留共同 U 定位並解除 ARM |
| 實際 Mega `.ino` 介面 | 搭配 Arduino stub 執行；原 USB 指令相容、USB 轉動中輸入仍停止整批、Serial1 狀態不打斷運動、遠端 STOP 結束 USB WATCH、SAVE／LOAD 不自動恢復 ARM；三位文字時實際輸出模型同時三位通電，未啟用 GPIO 始終 LOW |
| 共用協定 | 4,000 組 COBS／CRC 封包；逐段輸入、雜訊、位元損壞、溢位、100ms 半包逾時、設定序列化與範圍驗證 |
| Mega EEPROM | 每次寫入前後模擬斷電；有效舊槽保留、提交後選新槽、壞 CRC／錯版本／非法設定拒絕；版本 1→2 遷移的 0～134 次寫入中斷均可恢復，僅舊 5000／400 預設改成 800／800，保留自訂校準；重開機不 ARM／不恢復定位 |
| 遠端控制 | 接受／完成／拒絕／故障、重複與退役命令 ID、忙碌拒絕、STOP 優先、重新握手不重播、USB 接管、失聯解除 ARM／定位 |
| ESP32 工具／HTTP fixture | 13 項 Python 測試：建置／燒錄失敗流程、封裝長度／晶片／雜湊／版本、五項 gzip 資源解壓後與來源完全一致、VS Code 任務與 SVG、模擬登入／CSRF、整份配置驗證、OTA 停止票證與失敗後失效；未接 Mega 可保存 Wi-Fi，ARM 仍拒絕，維護期間拒絕網路更改 |
| 正式 C++ 網頁資料處理 | 全 45 個 UTF-8 字元、ä／ö／ü、NFC 組合、空白／別名、左中右對齊、長度、閏日／時區與各種位數；實際 cJSON 解析器測試錯型別、範圍、尾隨內容、NUL、深度及整份設定 |
| 兩板正式通訊核心 | `BridgeEngine` 直接連 `Remote`；模擬每毫秒 11 bytes 與 Mega 64-byte RX，所有 1～10 位並行、只對啟用位置輸出；遺失 ACK／DONE／整個命令、快取退役、STOP、USB、OTA 維護鎖、斷線／重連、協定版本不符；Mega 保存後 ESP32 保存失敗能維持 job=fault／storage |
| 單向失聯 | 只切斷 ESP32→Mega；Mega 兩秒後停止，ESP32 即使仍收到狀態也進入不確定狀態；需 STOP／Claim，遲到命令不能重新啟動 |
| 慢速十位批次 | 十位各從空白到 !、SPEED 5000；同時開始，30 秒內全部完成，總時間不再逐顆累加 |
| 最後字元保存模型 | 十組實體 ID 各自保留；全 45 字元往返、版本／長度／CRC／範圍拒絕、非法資料不覆寫、未完成／無可信定位不覆寫歷史、未改變不重寫；歷史不自動成為定位或 ARM |
| Wi-Fi 設定條件 | 正式 C++ 判斷函式測試初次無 Mega、斷線後殘留 busy 狀態均可設定網路；連線中運動／保存／監看、待完成本地工作與 OTA 維護仍拒絕 |
| VS Code 主機偵錯 | 前版已驗證 `test_bridge_debug.exe`／PDB 建置與執行；本版一般原生測試已通過，F5 的 preLaunchTask 會重建偵錯產物。未宣稱已互動操作中斷點，也不是實板硬體偵錯 |

電腦上的 UART、EEPROM 與 Hall 都是理想替身。它們不能量測電壓、真實串列誤碼、GPIO 時序、馬達扭力、漏步、溫升、磁極或實際斷電的電氣行為。

## 手機網頁流程

隔離 Chrome／Playwright 1.62.1，390×844 手機尺寸及 1100×900 桌面尺寸，正式 HTML 連本機模擬 Mega。七組流程通過，未捕捉到 JavaScript 例外：

1. 未登入 API 拒絕；登入後手動記錄 Z、ARM、顯示 Ä；拒絕超長文字，未校時禁止啟動時鐘。
2. 三位依序 U7→U0→U2、手動定位、äA 正規化及補空白；拒絕 ß／中文，1～3 位不提供時鐘格式。
3. 五位 HELLO、手機校時、HH:MM、關閉／重開頁面保留已啟動工作、暫停及可用日期格式。
4. Wi-Fi 表單、匯出不含密碼／CSRF、非法重複位置整份拒絕、有效匯入、離線重連與重啟後全部未 ARM。
5. OTA 先 STOP；截斷檔、SHA-256 錯誤拒絕且不重啟；失敗訊息可重新準備；有效檔模擬更新／重啟，手機與桌面沒有頁面橫向溢出。
6. 首次無 Mega 時可輸入／保存 Wi-Fi，重新載入保留；Mega 隨後連線不覆寫使用者正在輸入的 SSID。馬達控制保持停用；維護時按鈕與 API 均拒絕網路更改。
7. 調整 SPEED／ACCEL 後字元 Ä、定位與 ARM 保留；四張 SVG 經登入載入並解碼成功、手機頁面無橫向溢出；重開機顯示 HELLO 歷史但不自動 ARM，核對後一次操作完成 SETTEXT 與 ARM。

[手機預覽](ui-preview.jpg) 使用模擬資料。詳細結果及失敗截圖放 `esp32cam/test/.build/`。模擬器使用測試登入頁、記憶體設定與模擬 OTA；正式韌體的 Digest 驗證、FreeRTOS／Wi-Fi／NVS、HTTP 串流 Flash 寫入與每分鐘排程仍須實板驗收。關閉頁面測試確認模擬設備工作狀態保留；不是實際馬達或跨分鐘運轉紀錄。

## 重跑方式

```powershell
python mega2560/tools/dev.py test
python esp32cam/tools/dev.py test
python mega2560/tools/dev.py build
python esp32cam/tools/dev.py build
python esp32cam/tools/dev.py native-debug
python esp32cam/tools/dev.py test-web
```

工具準備與可選瀏覽器依賴見 [安裝指南](README.md)。一般建置不開啟 COM 埠。兩張 SVG 已轉圖人工檢查文字、電源分支、UART 方向、共地、CP2102 供電腳不接與 GPIO0 操作；沒有做電路模擬。

## 已有實機紀錄

使用者先前回報 U0 USB 單顆手動測試數輪無偏移：SPEED=800、ACCEL=800、REVSTEPS=4096、OFFSET=0、DIR=1、ORDER=1234、POLARITY=LOW，SHOW Z 後為 MANUAL／index 26／error=none。原始紀錄見 [Mega 驗證](../mega2560/validation.md)。這不代表本次 ESP32、其餘九位或 Hall 已通過。

2026-10-25 後續 USB 排查：使用者確認 CP2102 已與 ESP32 完全分離、只接電腦 USB。Windows 顯示 `VID_10C4&PID_EA60`、錯誤碼 28，修復前無 COM。Silicon Labs 網站拒絕工具下載，改用 Microsoft Update Catalog 的 11.5.0.417 AMD64 套件；官方 SHA-256 與 Microsoft 硬體相容簽章驗證通過，安裝成功。裝置狀態 OK，專案查詢回 `COM4 serial Serial Port (USB) Unknown`。此結果只確認 CP2102 驅動／USB 列舉；未開啟 COM、驗 ESP32 UART、重新接線或燒錄。ESP32 的 VCC／5V 實際接腳仍待確認。

之後使用者回報已成功燒錄 ESP32，並可進入手機網頁的「裝置設定」；家用 Wi-Fi 保存按鈕被停用。程式重現為舊版 1.0.0 將網路保存誤綁到 Mega 連線條件，1.0.1 已修正並通過上述離線首次設定測試；後續實板已取得家用網路 IP，且可從電腦到達 HTTP 登入入口。

2026-10-25 實機 UART 排查：使用者量得 P011 VCCA=3.3V、VCCB=5V、A1=3.3V、B1=5V。先將供電整理為 Mega 僅由電腦 USB 供電、ESP32 由 LM2596 5V 供電，移除 Mega 外部 5V，馬達分支保持關閉。直接讀 COM3，確認板上開機訊息為 `Mega panel + ESP32 link v1`，U0 未 ARM、定位為 NONE；COM4 起初回報 `Mega=offline`。

| 實板測試接法 | 速率 | 結果 |
| --- | --- | --- |
| CP2102 TXD→A0、RXD→A1，B0↔B1 短接；Mega D18／D19、ESP GPIO13／14 均分離 | 115200、38400、9600，各一次 | 每次 TX=240、RX=240 bytes，回傳與送出內容逐 byte 相同；短接完成前的零接收紀錄不作板卡失敗判定 |
| CP2102→P011→Mega Serial1；ESP GPIO13／14 分離，B0／B1 短接線移除 | 115200，8 秒 | TX=600、RX=29,848 bytes；8 個 WELCOME、16 個 PONG、32 個 PANEL、320 個 UNIT、32 個 CONFIG，沒有 CRC／長度錯誤；取得 U0～U9 軟體狀態與完整設定，DIGITS=1 |
| 恢復 ESP GPIO13→A0／B0→Mega D19、Mega D18→B1／A1→ESP GPIO14；CP2102 接回 U0R／U0T | 115200，約 8 秒 | 連續八次 STATUS 均為 `Mega=connected digits=1 running=0`，取得 STA IP；測完串列埠均已釋放 |

診斷送出的二進位封包僅有 HELLO／PING／QUERY，沒有 ARM、運動、設定或保存指令。另以未登入 HTTP 請求檢查設備根頁及 `/api/state`，兩者均回 401 Digest，確認家用網路可到達且登入保護存在；未取得密碼或繞過驗證。

此次在供電整理及重新插接後恢復通訊，沒有改韌體或新增零件；未能單獨定位最初失聯的接線／接點原因。現有 P011 已通過上述短時間實板測試，不能據此推定多顆機構存在、抗馬達干擾、十分鐘連線、運動中狀態查詢或失聯停止已通過；下列完整驗收項目仍保留待測。

後續使用者回報手機已可控制，但轉動很慢。1.1.0 因此改用 800／800 預設、並行排程、差異套用校準、字元歷史與頁內接線圖。上述實機紀錄都發生在此次改版之前，不代表本版多顆運轉或持久化已在實板驗證。

2026-10-26：使用者回報現版「實際測試通過，目前完美運行」，記為 1.1.0 現場運行通過的使用者回報；未另附位數、負載、Hall 或逐項斷電／失聯／OTA 紀錄，不代替下方各項完整驗收。後續 [雙板統一更新研究](dual-update-research.md)尚未實作或燒錄，本次沒有改動正常運行的韌體。

## 實機驗收順序

所有未勾選項目仍待現場執行，完成時記錄板號、參數、日期與結果。

- [ ] **供電**：關馬達分支，拔 Mega USB，空載調 LM2596 5.0V 後才接兩板 5V 腳；先不接四條 UART 訊號線。量 P011 VCCA／A0／A1 約 3.3V、VCCB／B0／B1 約 5V，核對共地；再關電接訊號。兩板負載時量 5V、3V3 與壓降。Mega 接電腦 USB 前須先拔外部 5V 與四條 UART 訊號線，完成後拔 USB、關控制電源再復原。
- [ ] **燒錄／安全開機**：先更新 Mega，再經 CP2102 更新 ESP32。GPIO0 跳線移除、RESET 後取得 ACCESS；兩板開機均不轉、不 ARM。
- [ ] **板間 UART**：以短跳線接 GPIO13→P011 A0／B0→D19、D18→B1／A1→GPIO14，兩板都供電；先不開馬達分支，以 115200 連線持續讀狀態至少十分鐘，確認不中斷，再確認 U0 運動時查詢不會停止馬達。此項是現有轉換板的實板驗證，不能用主機串列模擬代替。
- [ ] **首次手機登入**：直連 AP、設備隨機密碼及 admin Digest 登入，未登入／錯 CSRF 操作拒絕。家用 Wi-Fi、IP、splitflap.local、重連及 AP 備援可用。
- [ ] **U0 手動定位**：只啟用一位；記錄實際字元、ARM，先短距離再跨圈，核對目標、45 字元及重複停點；確認 STOP 釋放線圈並使位置失效。
- [ ] **手機離線**：文字移動中關頁面應完成；校時啟動時鐘後關閉頁面，跨多個分鐘確認仍運作。忙碌跨分鐘時完成後只追最新目標。
- [ ] **兩秒失聯**：保留兩板供電，遠端運動時分別斷開 ESP→Mega、Mega→ESP 及雙向 UART，確認 Mega 於租期到期停止、解除 ARM／定位；另測 ESP32 RESET，確認重連不重播、須重新定位並啟用。現有轉換板不假設斷電隔離，不保留訊號線熱拔單側電源。獨立 USB 調機先依接線表拆除板間訊號與外部 5V。
- [ ] **USB 接管**：USB 控制後網頁提示接管；時計暫停；Claim／STOP 後不會自行恢復運動。
- [ ] **持久化**：驗舊 EEPROM 5000／400 升級後為 800／800，自訂校準不變；調速保存後定位與 ARM 保留。保存校準、位數／順序、Wi-Fi／偏好及最後字元後重開兩板；設定與歷史恢復，可信定位／ARM／自動顯示不恢復。核對歷史字元，一次確認後才可轉動；移動中斷電不能誤當已到目標。匯入先拒絕非法檔，再確認有效檔完整套用。
- [ ] **其餘位置**：逐顆驗 U1～U9 的 IN1～IN4、電源與運動，再測實際使用位數、非連續順序與整串文字；不同目標須一起起步、各自停止、相同字元不動；測並行 STOP／故障後全組停轉及負載壓降，未啟用輸出維持關閉。
- [ ] **磁鐵／Hall**：裝磁鐵後量有效極性、原始／去抖狀態、HOME、三圈 MEASURE、OFFSET 與 CYCLE；本次沒有真實磁鐵驗收。
- [ ] **實際 OTA**：停止確認後先驗錯檔拒絕，再測有效更新；測中斷上傳可重試、上傳時 UART 仍有心跳、Mega 失聯／USB 啟動會中止。更新後設定保留、仍需定位與 ARM；中斷供電測試在已停止且備有 USB 復原方式時做。
- [ ] **長時間負載**：實際多位文字／時鐘、5V 穩壓、接點壓降、馬達／ULN／降壓器溫升、抗干擾與實體馬達支路切斷。

軟體 STOP 不能切斷 12V，也不能在控制器／供電故障時保證關閉。接線依 [逐線表](wiring.md)與兩張圖；新位置先逐顆確認，再擴充。
