zx90316/split-flap/mega2560/validation.md

# Mega 2560 驗證紀錄

更新日期：2026-10-31（Asia/Taipei）。軟體驗證、串列實機測試與使用者回報的實機進度分列，尚未完成完整機構驗收。

## 2026-10-31：P011 冒煙後複測

使用者回報 P011 VCCB 供電處短路冒煙，事故當時 Mega 是以 5V 接 VIN。隔離 P011、外部電源及全部外接線後，只接 Mega USB；COM5 正式開機選單及三次 `STATUS ALL` 均正常，U0 `armed=0 homed=0 reference=NONE error=none`。確認主晶片於 USB 供電下仍能運行；D18／D19、其他 I/O 及 VIN 穩壓路徑尚未測試。沒有重新燒錄、改設定或運動。詳見[事故後主控檢查](../esp32cam/validation.md)。

## 2026-10-31：新 Mega2560 Pro USB 初驗

新板換 USB 線後於本機 `COM5` 正常列舉；唯讀取得 ATmega2560 簽章 `1E 98 01`，115200 Wiring／STK500v2 bootloader 通訊成功。正式韌體重建、USB 燒錄並啟用驗證成功；容量仍為 Flash 32,110 bytes、全域 RAM 2,360 bytes。燒錄前後各備份 4,096-byte EEPROM，兩份皆為 `0xFF`、雜湊一致，沒有改寫或匯入校準。

開機顯示正式選單，兩次 `STATUS ALL` 回覆 `DIGITS=1 UNITS=0`、U0 `armed=0 homed=0 reference=NONE error=none`；目前為預設 `REVSTEPS=4096 OFFSET=0 SPEED=800 ACCEL=800 DIR=1 ORDER=1234 POLARITY=LOW`。舊 U0 的 OFFSET=273 等校準尚未搬移；本次沒有 ARM 或運動，也未驗證 Hall、板間 UART 或外部供電。兩板完整紀錄與驗收邊界見 [新板 USB 初驗](../esp32cam/validation.md#2026-10-31新板-usb-燒錄與開機初驗)。

## 使用者回報的實機進度

2026-10-25：已完成 COM3 上傳，串列輸出本版選單；ARM／STEP 回覆 BUSY、DONE，無軟體故障。使用者確認馬達外殼標示12V、ULN正負端量到12V。起初ULN閃燈、馬達嗡叫但不轉，發現IN1插在D22旁的錯誤接點；修正後回報已能轉動。

此紀錄確認初次上傳與單顆試轉進度，不代表已通過 HOME、每圈步數、OFFSET、45片、熱穩定或十顆同時運作驗收。

後續使用者回報：加減速版設定SPEED 1500「速度都還行」；磁鐵尚未到貨，並確認沿用原版45片字元順序。這是使用者對試轉的回報，未包含量測或完整負載／定位驗收。

2026-10-25手動定位版後續：使用者回報「測試通過，測試數輪皆無偏移」，並提供SHOW Z完成後與再次查詢的相同STATUS：

```text
SHOW Z
BUSY (any non-newline byte stops)
DONE coils off
U0 armed=1 homed=0 reference=MANUAL value=Z index=26 REVSTEPS=4096 OFFSET=0 SPEED=800 ACCEL=800 DIR=1 ORDER=1234 POLARITY=LOW error=none
```

記錄為**U0手動定位模式在SPEED 800µs、ACCEL 800半步/s²、REVSTEPS 4096設定下，多輪測試無可見偏移（使用者回報）**。其餘設定為OFFSET 0、DIR 1、ORDER 1234、POLARITY LOW；目前位置Z、第26格，無軟體錯誤。4096是測試使用的設定值，尚未以霍爾量測實際圈步數。

具體回合數、逐項目標／CYCLE紀錄與溫升未提供；本次回報不擴大到ACCEL 6000、霍爾歸零或十顆同時驅動的驗收。

初次多位版新增 1～10 位安裝配置、各位獨立狀態與逐顆整串更新；當時尚未測試該多位版實板。後續手機控制已由使用者回報可用，板間通訊紀錄見 [ESP32-CAM 驗證](../esp32cam/validation.md)。上方 U0 結果保留為已知參數基準，未擴大到此次並行版。

## 本次並行版與設定保留

2026-10-25：Mega 與 ESP32-CAM 1.1.0 配合更新。預設 SPEED 800／ACCEL 800；TEXT、HOME ALL、CYCLE ALL 同時開始，各自完成；未啟用位置不輸出。速度／加速度與無變更設定保留定位、ARM；幾何校準只使受影響 U 失效，安裝映射改變則解除 ARM，保留共同 U 的定位。ESP32 保存最後完成字元供重開後確認，不自動恢復定位或 ARM。

| 項目 | 最新結果 |
| --- | --- |
| 正式 AVR 建置 | Arduino CLI 1.5.1、arduino:avr 1.8.8；Flash 32,110／253,952 bytes，全域 RAM 2,360／8,192 bytes；無專案警告 |
| 運動／多位核心 | 15 組 bench、7 組 panel 通過；1～10 位同時起步、並行批次時間、相同字元略過、單位故障／STOP 結束全部、非連續映射、設定差異套用與定位保留 |
| 實際 `.ino` 主機模型 | 三位 TEXT 同時三位有線圈輸出；只對啟用 GPIO 輸出、狀態查詢不中斷運動、USB 停止整批、相同設定載入保留狀態 |
| EEPROM／通訊 | 4,000 組 COBS／CRC、重複／失聯／STOP 測試通過；版本 1→2 遷移模擬 0～134 次寫入中斷，舊 5000／400 轉 800／800，自訂參數保留 |
| 工具 | 9 項 Python 工作流程測試通過；建置與測試沒有開啟實板埠或燒錄 |

完整兩板、字元保存與手機頁面結果見 [整合驗證](../esp32cam/validation.md)。本版並行機構、負載／壓降、實際失聯與保存斷電驗收仍待現場執行。

2026-10-26 後續：使用者回報現版「實際測試通過，目前完美運行」，記為現場運行通過；沒有另提供位數／逐項負載、Hall 或斷電驗收紀錄。後續單 USB／單包雙板更新為 [設計研究](../esp32cam/dual-update-research.md)，目前未修改本版韌體。

## 2026-10-26：U0 磁鐵歸零初測

使用者確認只有 U0 裝好磁鐵。本次直接經 COM5（USB-SERIAL CH340）操作既有 `Mega panel + ESP32 link v1` 韌體；只選取、ARM 及轉動 U0，未燒錄兩板、未操作 ESP32、未寫入 EEPROM。安裝設定仍為 `DIGITS=4 UNITS=0,1,2,3`，U1～U3 均未 ARM 或轉動。

U0 實際讀回參數為 `REVSTEPS=4096 OFFSET=0 SPEED=800 ACCEL=799 DIR=1 ORDER=1234 POLARITY=LOW`。HOME／MEASURE 使用韌體固定的至少 5000µs 半步間隔。

| 操作 | 串列實測結果 |
| --- | --- |
| `WATCH` | 啟動馬達前曾讀到 `A0 raw=LOW U0=1`，之後回 `HIGH U0=0`；未同步記錄實物操作，不單憑此段判定磁鐵／感測器類型 |
| 第一次 `HOME` | 約 1.1 秒後 `DONE coils off`；`homed=1 reference=HALL value=BLANK index=0 error=none` |
| 在剛歸零位置再次 `HOME` | 約 21.7 秒後再次完成且 `homed=1 reference=HALL error=none`；通過先離開有效磁區、再找新觸發邊緣的流程 |
| `MEASURE` 三個完整圈 | 4094、4098、4096 半步；平均 4096，最大差 4 半步，高於本文件初驗目標的 2 半步；量測完成時韌體 `error=none` |
| 測試結束 | 主機因量測差超過初驗目標而停止後續測項，送出 `OFF`，收到 `OK ALL stopped; disarmed, positions invalid`，並關閉 COM5 |

初測結論：**U0 的霍爾歸零流程已連續完成兩次；圈步數平均支持保留 4096，重複性目標尚未通過。** 初測未修改 `REVSTEPS` 或 `OFFSET`。MEASURE 及最後 OFF 會清除定位，因此測試結束時不保留 `homed=1`。原始串列紀錄保留於本機忽略目錄 `mega2560/.build/hall-home-u0-2026-10-26.log`。

使用者隨後回覆實物停在 `-`（第 42 格），確認 `OFFSET=0` 尚未對準空白頁。依既有順序 `- → ? → ! → 空白`，三格估值為 `4096 - positionFor(4096, 42) = 273` 半步；這是依字元推估，仍需目視確認翻片完整落下。

後續只暫設 U0 `OFFSET 273`，重新 `ARM`，連續執行兩次 `HOME`，分別約 23.1／21.7 秒後完成；兩次均回報 `homed=1 reference=HALL value=BLANK index=0 OFFSET=273 error=none`。**使用者確認「空白，翻片完整落下」後，已執行 SAVE 保存，再以 LOAD／STATUS ALL 核對 U0 OFFSET=273。** U1～U3 仍未 ARM，設定未變；完成後 `OFF` 並釋放 COM5，位置與 ARM 均不保留。保存核對沒有轉動馬達，未另做斷電重開驗收。

圈步數維持 4096；本次校準未重做三圈量測，不改變上方最大差 4 半步的結果。後續串列紀錄為 `mega2560/.build/hall-offset-u0-2026-10-26.log`，保存／重新載入紀錄為 `mega2560/.build/hall-offset-u0-save-2026-10-26.log`。

## 可重複的軟體檢查

```sh
# 主機行為測試：需 g++／clang++（C++11）
python mega2560/test/run.py
# 也可使用 Zig 的 C++ 編譯器
python mega2560/test/run.py --zig /path/to/zig

# AVR 編譯，不上傳
arduino-cli core install arduino:avr@1.8.8
arduino-cli compile --fqbn arduino:avr:mega:cpu=atmega2560 --warnings all mega2560/unit_test

# 從同一份韌體腳位表重建三張 SVG
python mega2560/generate_wiring.py
```

以下保留先前 USB 多位版的建置與測試基準；其中逐顆排程及容量為當時行為，最新並行結果以上一節為準。

| 項目 | 先前 USB 多位版結果 |
| --- | --- |
| AVR 交叉編譯 | Arduino CLI 1.5.1，arduino:avr 1.8.8，AVR GCC 7.3.0，ATmega2560；成功 |
| 程式／RAM | 多位版 Flash **16,654 / 253,952 bytes**；全域 RAM **1,508 / 8,192 bytes**；不含執行時堆疊使用量 |
| 診斷 | 專案程式無編譯警告；首次完整建置有 Arduino 核心 new.cpp 未使用參數警告，未改第三方核心 |
| 純運動核心 | 15組行為測試通過：原有boot/ARM/STOP、已有磁區歸零、正向跨圈、Hall故障／5ms去抖、三圈量測、鎖存模型、45片循環、相序／方向、步數／時間上限、延遲不追趕、迴圈停滯、micros溢位、腳位唯一性、加減速與立即停止／重啟；新增高速巡航、手動目標、手動整圈／位置失效、字元映射 |
| 加減速輸出時序 | 觀察主機模型的步進排程時間：1／2／3／8／91／500／1500／20000半步，三角形與梯形曲線、前後對稱、起末10000µs、巡航不快於設定、最大20000步／ACCEL 6000的乘積；800／1000／1200µs長距離巡航；約一片91步在ACCEL 400與6000的差異；不代表實板波形量測 |
| 手動定位／跨圈 | 每圈4076與4096下各45×45、共4050組起點／目標：同頁不動、只前進、跨圈、數值更新；正／反電氣方向；連續45次翻頁的步數總和等於一圈，1000／20000圈步數邊界與時間溢位；全程只允許Moving／Settle／Pause，無Hall歸零 |
| 手動CYCLE／失效 | 從第0／17／44格各翻整圈4076步回原格；噪音Hall不影響；SET不輸出、不自動ARM，運動中拒絕直接SET；STOP／設定／RAW／LED取消位置；顯式HOME可恢復霍爾模式 |
| 歸零與量測隔離 | SPEED 5000與1500在理想模型中的HOME／OFFSET步數、停點與時間一致；高速設定下MEASURE各步至少5000µs、三圈各1000半步；未測真實磁鐵或高速漏步 |
| 多位控制核心 | 新增6組通過：每一種DIGITS 1～10、非連續／重排UNITS、UNIT切換保留參數／位置／ARM／極性、未啟用位置不動、全組參數作用範圍、TEXT就緒與字元完整預檢、相同字元略過、跨圈、全組STOP取消待執行位置、故障／迴圈停滯取消全組、逐顆CYCLE ALL與理想磁區HOME ALL、文字解析；每輪檢查最多一位有線圈輸出 |
| Arduino 介面 | 實際.ino搭配stub通過：原單位SET／SHOW、步進、WATCH、極性與CRLF；DIGITS 1～10、未啟用UNIT拒絕、獨立狀態、UNITS順序、SETTEXT／TEXT空白與引號、短文字補空白、空文字清空、錯字元／長度拒絕、SPEED ALL／ACCEL ALL、批次中輸入取消全部且不執行該行、未定位禁止TEXT、HOME ALL故障取消與CYCLE ALL。每輪檢查40個模擬GPIO只對啟用U輸出HIGH且最多一顆通電 |
| 主機工具 | Zig 0.16.0；專案測試以 C++11、-Wall -Wextra -Werror 編譯；Zig 首次建立標準函式庫有第三方 nullability 警告 |
| 圖面 | 三張SVG由pins.h生成；已轉成PNG人工檢視文字、線路、電源域及孔號；非Wokwi電氣模擬 |
| 文件／BOM | 與程式腳位、U9 D8–D11、單顆／十顆數量分開核對；原ESP32 BOM保留，歷史文件改指向該版本 |
| VS Code 工作流程 | 9項測試通過：先建置再驗證上傳、建置失敗不燒舊檔、上傳失敗不開監控、成功後才開監控、缺少／非法連接埠拒絕、建置不開埠、輸出路徑限制、Windows停止啟動器會清除子程序 |
| VS Code 原生偵錯產物 | bench／panel／adapter三組C++ Debug EXE／PDB均成功建置並執行通過；新增「多位顯示排程」入口。JSON、任務唯一性、三組launch／preLaunchTask／二進位／PDB對應及唯一預設建置檢查通過 |

VS Code 配置驗證未包含互動式中斷點／單步操作；本次未再次開啟實板COM埠或燒錄。實板串列除錯與電腦上的模擬中斷點入口見 [VS Code 指南](vscode.md)。

主機模型用理想磁區與理想轉子，不模擬扭力、慣性、線圈電流、接觸電阻、漏步、回灌、波形、機構卡滯、真實磁極或USB供電。鎖存模型通過不代表使用者手上模組已確認鎖存，亦不代表雙磁鐵機構已完成。既有ESP32 Wokwi驗收不能當作Mega驗收。

## 實機驗收進度

單顆上傳與試轉的使用者回報見上方；已勾選項目僅代表所述範圍，未勾選代表該整項仍未完整驗收。

- [x] U0手動定位：使用者回報SPEED 800／ACCEL 800／REVSTEPS 4096下測試數輪皆無偏移；SHOW Z與STATUS確認MANUAL、Z／26、error=none。
- [x] U0磁鐵歸零與空白頁：OFFSET=273時連續兩次HOME完成，使用者確認空白且翻片完整落下；已SAVE並LOAD核對。三圈步數差4半步，重複性目標仍待改善，未擴大到其他U。
- [ ] 多位版實機：逐顆確認U1～U9後，測試實際使用的DIGITS位數、UNITS映射、SETTEXT／TEXT、全組停止與部分完成後重新定位；其餘位尚未由使用者回報通過。
- [ ] 盤點Mega、ULN、12V馬達、Hall、線材的實際型號、數量、針序、公母頭與額定值。
- [ ] 驗證12V極性、保險絲、可及的馬達實體切斷、端子及主幹線規、共地回流。
- [ ] 斷電量ULN的COM、共同端、IN／插座映射；查模組LED及電阻可承受12V。
- [ ] USB控制電源電流／壓降；單顆通過後才評估十片Hall負載及Mega GPIO各腳／各port／全晶片總電流限制。
- [ ] Mega開機、RESET、watchdog重設、USB拔除／控制域斷電時相位確實關閉；必要時加下拉。
- [ ] 每片Hall供電、輸出高低、上拉、有效磁極、移遠釋放及接入INPUT_PULLUP後的行為。
- [ ] 實際2×1mm磁鐵與機構距離、每圈邊緣；不根據3.39V或印字直接判定鎖存。
- [ ] 單顆LED、短步、平順前進、三圈步數、OFFSET、45片與跨圈HOME。
- [ ] 補齊手動定位各項測試紀錄：SET實際字元、SHOW正向／跨圈／連續目標、數字0與BLANK、45片CYCLE回同頁；目前已有多輪無偏移回報，尚無逐項紀錄與具體圈數。
- [ ] 系統驗證SPEED／ACCEL調整、短／長距離起停、負載下實際頁面與重複停點；已回報通過組合為800／800，其他組合與長時間運轉仍待紀錄；磁鐵到貨後重新確認OFFSET。
- [ ] 馬達負載與溫升、ULN溫升、接點壓降、噪音／假觸發、實體停止可用。
- [ ] 分別抄錄十顆校準值；尚未做十顆同時驅動或長時間運轉驗收。

空白核取方塊代表尚未完整驗證。EEPROM 雙槽保存、Serial1 版本化通訊、心跳、遠端控制與多顆並行排程已實作並通過主機測試；本版實板驗收尚未完成。Cardputer 與外接 RTC 待整合；位數與操作見 [多位指南](multi-unit.md)。
