zx90316/split-flap/firmware/esp32/test/native/test_characters.cpp

// SPDX-License-Identifier: GPL-3.0-only
#include "characters.h"
#include <cassert>
#include <iostream>
int main(){uint8_t x[10]={};
  assert(splitflap::parseText("AZÄÖÜ09:?!",x,10));
  const uint8_t expected[10]={1,26,27,28,29,30,39,40,43,44};
  for(int i=0;i<10;i++)assert(x[i]==expected[i]);
  assert(splitflap::parseText("$&#",x,10,true));assert(x[0]==27&&x[1]==28&&x[2]==29&&x[9]==0);
  assert(!splitflap::parseText("$",x,10));assert(!splitflap::parseText("Ä",x,10,true));
  assert(!splitflap::parseText("a",x,10));assert(!splitflap::parseText("AB",x,1));
  assert(!splitflap::parseText("\xc3",x,10));assert(!splitflap::parseText("你好",x,10));
  assert(splitflap::parseText("",x,10));for(int i=0;i<10;i++)assert(x[i]==0);
  // JonnyBooker Unit/Unit.ino TEST_ENABLE commissioning sequence at 0c6ef692.
  assert(splitflap::parseText(" ZAUN?0129",x,10));
  const uint8_t commissioning[10]={0,26,1,21,14,43,30,31,32,39};
  for(int i=0;i<10;i++)assert(x[i]==commissioning[i]);
  uint8_t all[45]={};
  assert(splitflap::parseText(" ABCDEFGHIJKLMNOPQRSTUVWXYZÄÖÜ0123456789:.-?!",all,45));
  for(int i=0;i<45;i++)assert(all[i]==i);
  std::cout<<"Character order, UTF-8, alternative flaps, padding and rejection tests passed\n";
}
