zx90316/split-flap/(commit log)

2026-10-20 Add ESP32 module-based split-flap firmware and purchased-BOM build plan
    Use four MCP23017 expanders, safe serial commissioning, nonblocking motion,
    per-unit calibration, native and adapter tests, and Traditional Chinese wiring
    and assembly documentation. Preserve upstream mechanics and GPL attribution.
    Hardware remains unverified; no automatic motion or paid CI.
    [ordered-bom.csv]
2026-10-20 docs: define standard ESP32 project BOM and assembly requirements
    [optional-parts.csv, ordered-bom.csv, project-bom.csv]
2026-10-20 docs: adopt pinned JonnyBooker reference and verify ESP32 compatibility
2026-10-20 Add reproducible Wokwi ten-channel ESP32 digital wiring demo
2026-10-20 Run production ESP32 firmware in closed-loop Wokwi simulation
2026-10-25 Add Mega 2560 single-unit bench firmware and wiring
    [esp32-project-bom.csv, optional-parts.csv, project-bom.csv]
2026-10-25 Add ESP32-CAM web control with reliable Mega link and saved calibration
    [optional-parts.csv, project-bom.csv]
2026-10-25 Document CP2102 driver recovery and ESP32-CAM power pin checks
2026-10-25 Allow ESP32 Wi-Fi setup before Mega connects
2026-10-25 Use existing MOS level shifter for ESP32-CAM UART
    [optional-parts.csv, project-bom.csv]
2026-10-25 Record hardware UART bring-up and restored ESP32 link
2026-10-25 Evaluate ESP32-CAM single-controller MCP23017 architecture
2026-10-28 Support Mega2560 Pro and NodeMCU ESP-32S hardware
    Move the web controller to a classic ESP32 profile without PSRAM and give
    its OTA packages a separate identity from the old ESP32-CAM firmware.
    Retain the Mega motion parameters and recorded U0 Hall calibration.
    Update USB workflows, offline wiring diagrams, VS Code tasks and the
    purchased hardware inventory. Keep DIP switches spare and the relay
    optional. Correct the OTA protocol documentation and test wrong magic,
    project, protocol and image sizes independently.
    Validation: both firmware builds, Mega and ESP32 native/tool tests, seven
    browser workflows, generated resources and BOM/VS Code checks passed.
    No physical board was flashed or op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
    [optional-parts.csv, project-bom.csv]
2026-11-02 Add dual-controller 1.3.x web flows, calibration and OTA guard
    Page login sessions, ESP32-driven calibration/offset flow, power-restore,
    clock/text rotation, and OTA write guard that waits for a fresh Mega
    snapshot after each flash write.
2026-11-02 Implement NodeMCU ESP-32S single controller with MCP23017
    Build with `dev.py build --single` (SPLITFLAP_SINGLE). LocalController has
    the same interface as the Mega Bridge, so the 1.3.x web, login, calibration,
    power-restore, rotation and OTA flows run unchanged. Four MCP23017 at
    0x20..0x23 on GPIO21/22 (400kHz) with shared RESET on GPIO23 drive the
    ULN2003 inputs and read Hall; RESET is held during OTA and on any I2C fault.
    The motion core moves to libraries/SplitFlapMotion and is shared with the
    Mega firmware; the only addition is a default-on per-step permission hook.
    Separate OTA project (splitflap-32s-s1) keeps the two images apart.
    Software only: builds, native, Python and web tests p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
    [app.cpp, app.h, app_flow.cpp, board_profile.h, bridge_engine.h, control_state.h, dev.py]
2026-11-08 Add single-controller wiring diagrams
    wiring-single.svg shows power, ESP32, level shifter and the four MCP23017
    on one I2C bus with their ULN/Hall outputs; wiring-single-pins.svg maps every
    GPA/GPB pin to ULN IN1-4 and KY-003, plus module header and address straps.
    Both are generated by tools/generate_wiring.py, embedded in the firmware and
    shown on the web page in single-controller mode.
2026-11-08 Survive dropped loopback connections in OTA tool and mock
    A Windows traffic filter (AdGuard here) resets about 1 in 3 local
    connections when the server closes first after "Connection: close",
    which broke the paced-OTA fixture test.
    The mock server now waits for the client to close before closing its
    socket (0 resets in 150 tries). The OTA tool retries a request up to
    three times only when the connection drops before any response; reads
    and login are harmless to repeat and commands carry a deduplicated
    request ID. Firmware uploads are still never retried.
    [mock_web.py, ota_upload.py]
2026-11-08 Move Hall inputs to GPB0-4 (U0-U4) and GPA0-4 (U5-U9)
    Hall MCP 0x23 now uses five pins per port: GPB0-4 for U0-U4 and GPA0-4
    for U5-U9; GPA5-7 and GPB5-7 stay unconnected. Input/pull-up mask is
    0x1f1f. Adds a native test that checks every unit against its own pin.
    Diagrams and wiring table regenerated.
2026-11-08 Move U9 motor outputs to MCP 0x22 GPB0-3
    0x22 now drives U8 on GPA0-3 and U9 on GPB0-3; GPA4-7 and GPB4-7 stay
    unconnected. The fake bus in the native test models the physical wiring
    separately and asserts those unused 0x22 pins are never driven.
    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
